Mimek32/Engineering-Thesis/3D Scanner with IR sensor Central Unit.png

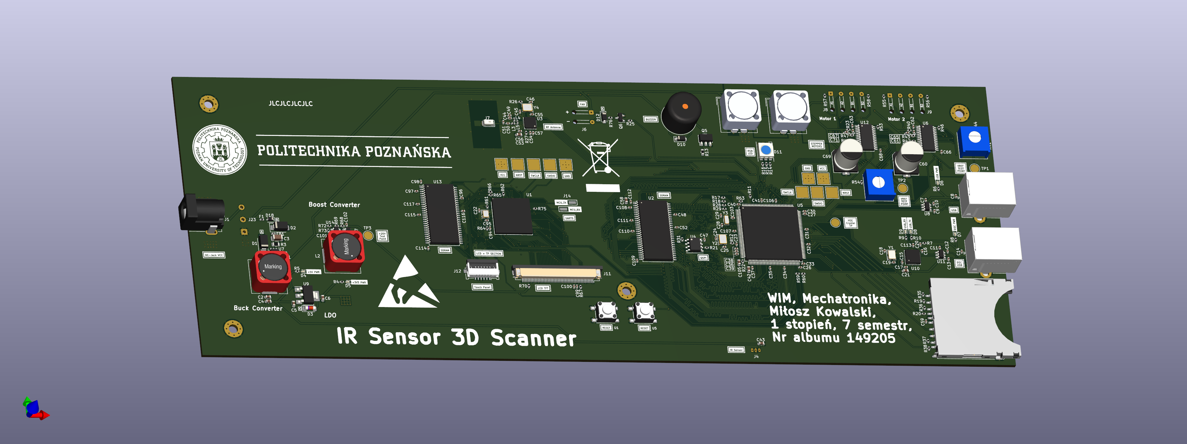
3D Scanner with IR sensor Central Unit.png
