Mimek32/Engineering-Thesis/README.md

# Engineering Thesis
## PCB
3D Scanner with IR sensor Central Unit
