Mimek32/Engineering-Thesis/3D Models/Download_STP_830069392 (rev1).stp

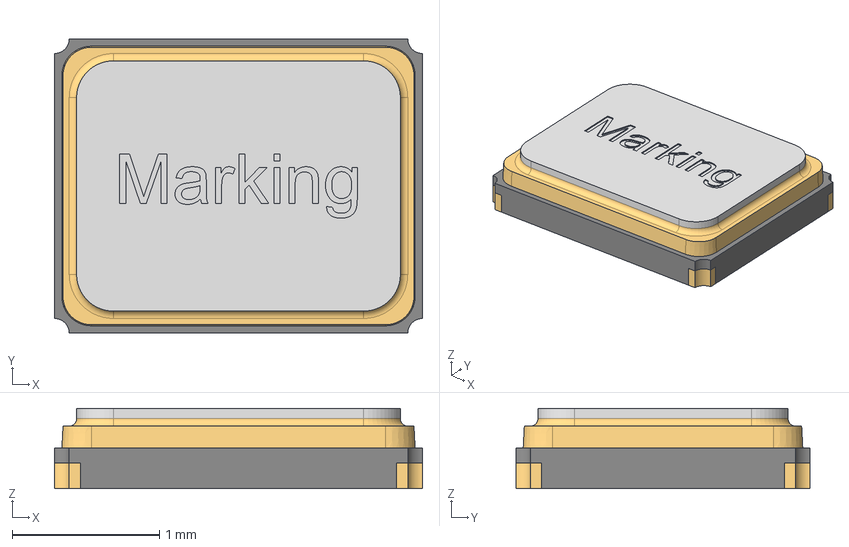
[picture p2: CAD file, 2023-10-10]
3D Models/Download_STP_830069392 (rev1).stp
2.50 x 2.00 x 0.545 mm
Pins
Cover
