Mimek32/Engineering-Thesis/3D Models/DRQ127-150-R.stp

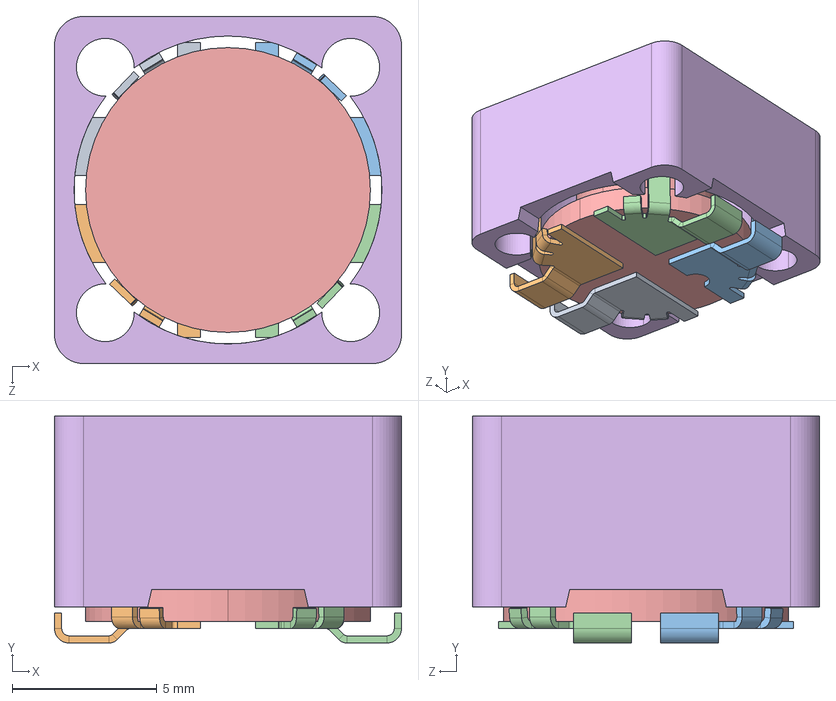
[picture p3: CAD file, 2023-10-10]
3D Models/DRQ127-150-R.stp
12.0 x 7.85 x 12.0 mm
40001700A
