Mimek32/Engineering-Thesis/3D Models/Download_STP_61400416121 (rev1).stp

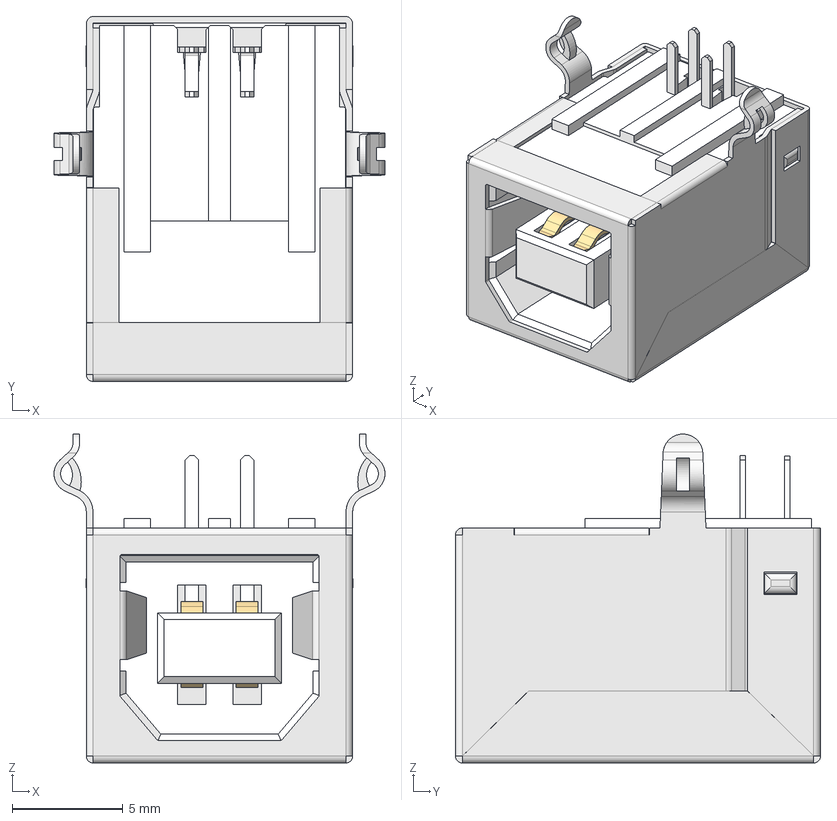
[picture p4: CAD file, 2023-10-10]
3D Models/Download_STP_61400416121 (rev1).stp
15.0 x 16.5 x 14.9 mm
61400416121_Insulator
61400416121_Shielding
61400416121_Pin_2 x 2
61400416121_Pin x 2
