Mimek32/Engineering-Thesis/3D Models/BRAK_OZNACZENIA_PRODUCENTA.stp

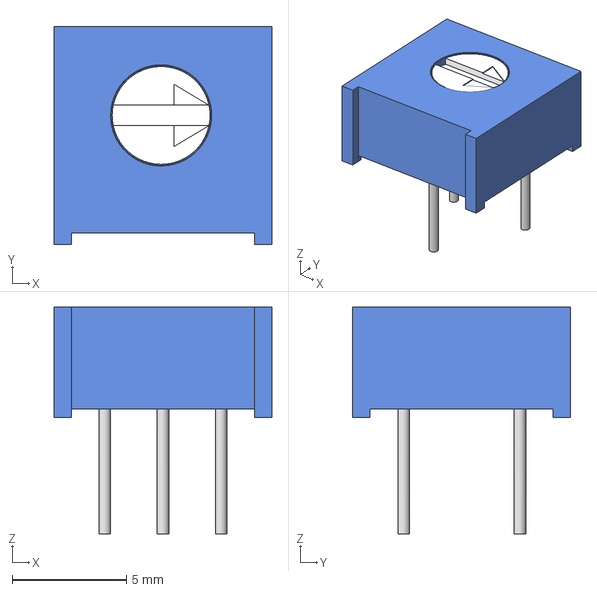
[picture p5: CAD file, 2023-10-10]
3D Models/BRAK_OZNACZENIA_PRODUCENTA.stp
9.53 x 9.53 x 9.90 mm
