Mimek32/Engineering-Thesis/3D Models/Download_STP_WL-SICW_0402 (rev1).stp

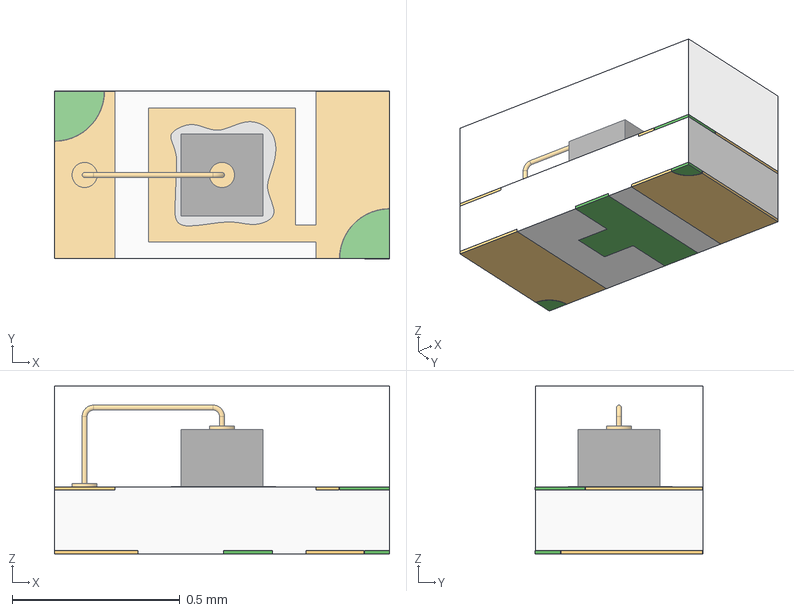
[picture p6: CAD file, 2023-10-10]
3D Models/Download_STP_WL-SICW_0402 (rev1).stp
1.00 x 0.5 x 0.5 mm
PCB
Resin
Pins
