Mimek32/Engineering-Thesis/3D Models/Download_STP_830108313809 (rev1).stp

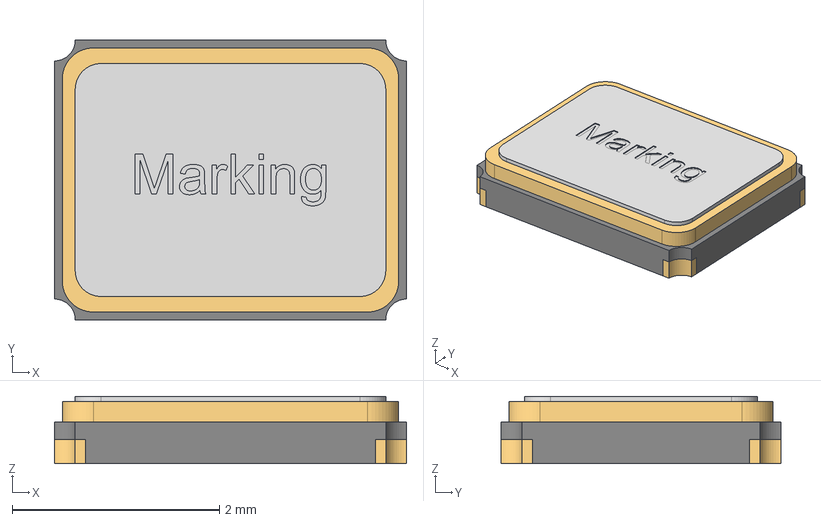
[picture p7: CAD file, 2023-10-10]
3D Models/Download_STP_830108313809 (rev1).stp
3.40 x 2.70 x 0.65 mm
Pins
Cover
