Mimek32/Engineering-Thesis/3D Models/3362P-1-102LF.stp

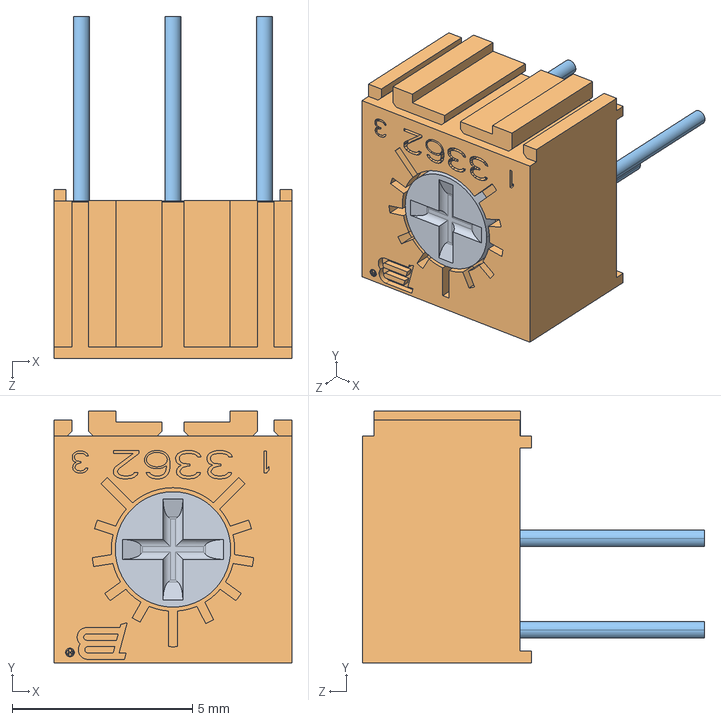
[picture p8: CAD file, 2023-10-10]
3D Models/3362P-1-102LF.stp
6.60 x 6.99 x 9.50 mm
