Mimek32/Engineering-Thesis/3D Models/Download_STP_830009678 (rev1).stp

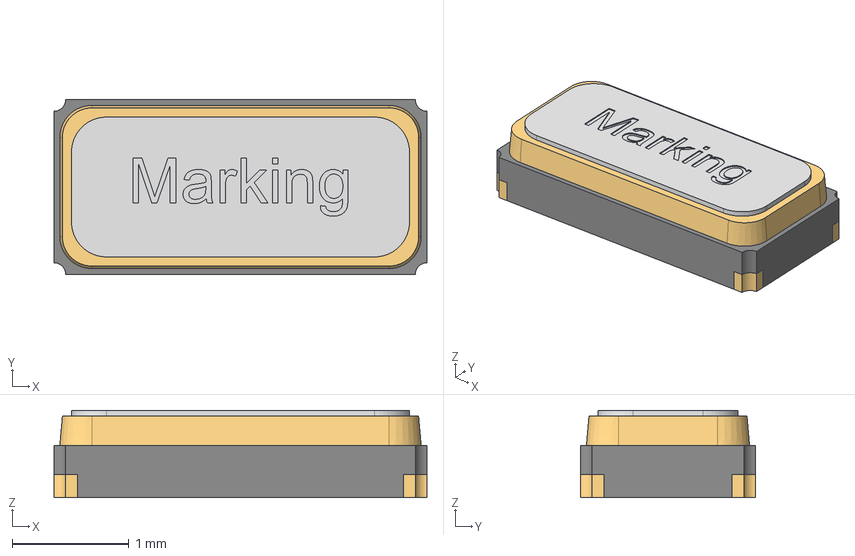
[picture p9: CAD file, 2023-10-10]
3D Models/Download_STP_830009678 (rev1).stp
3.20 x 1.50 x 0.75 mm
Pins
Cover
