Mimek32/Engineering-Thesis/3D Models/WE-PF_1280_PF (rev1).stp

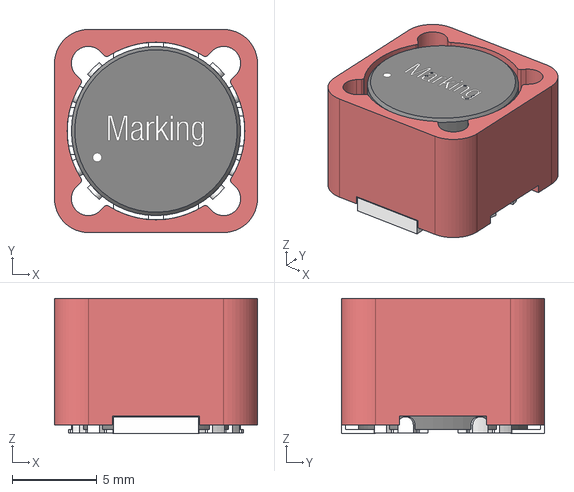
[picture p10: CAD file, 2023-10-10]
3D Models/WE-PF_1280_PF (rev1).stp
12.0 x 12.0 x 8.00 mm
