Mimek32/Engineering-Thesis/3D Models/68610614422 (rev1).stp

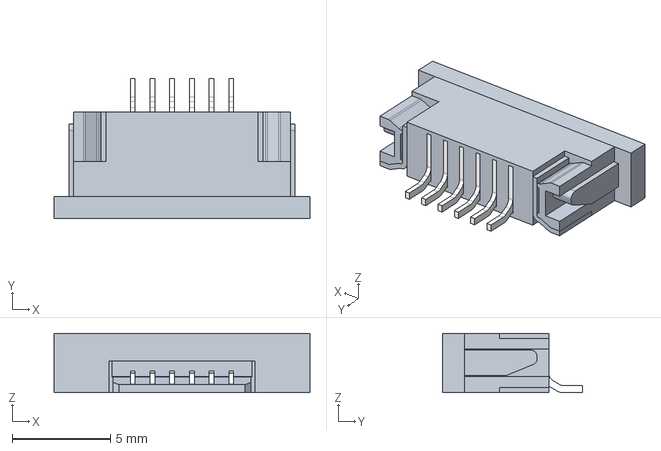
[picture p11: CAD file, 2023-10-10]
3D Models/68610614422 (rev1).stp
13.0 x 7.10 x 3.01 mm
