Mimek32/Engineering-Thesis/3D Models/430182043816 (rev1).stp

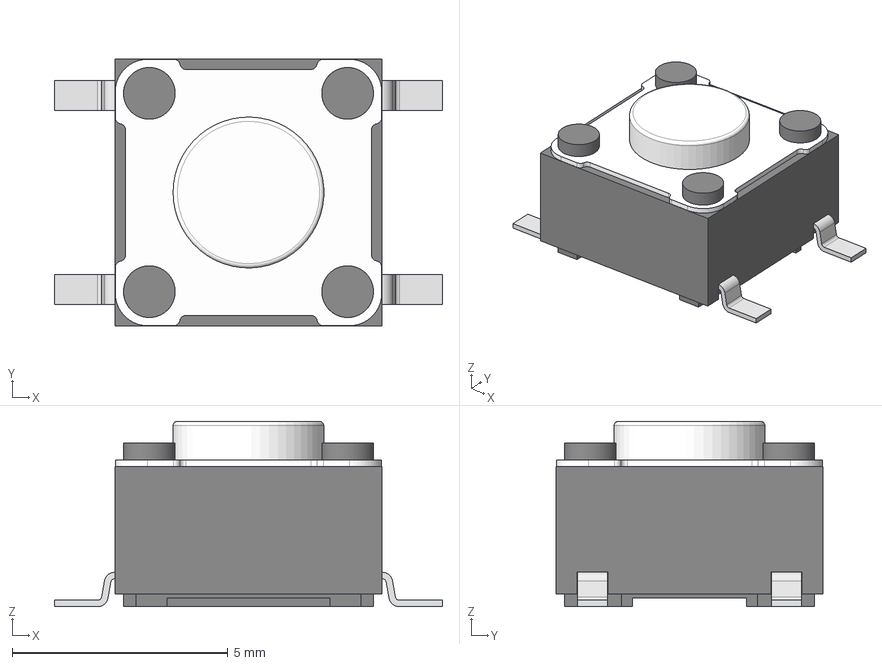
[picture p12: CAD file, 2023-10-10]
3D Models/430182043816 (rev1).stp
9.00 x 6.20 x 4.30 mm
