Mimek32/Engineering-Thesis/3D Models/693061010911 (rev1).stp

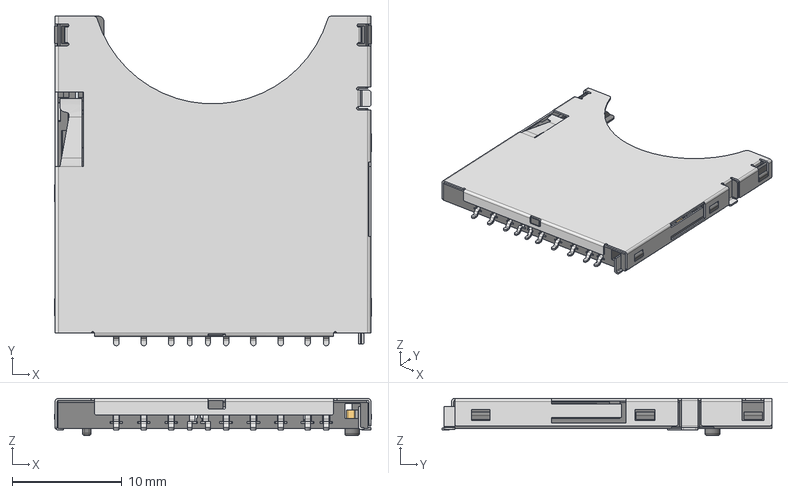
[picture p13: CAD file, 2023-10-10]
3D Models/693061010911 (rev1).stp
28.9 x 30.1 x 3.40 mm
693061010911_RESSORT
693061010911_PIN_MOY x 7
693061010911_COULISSEAU
693061010911_AGRAPHE
693061010911_PIN_SPE
693061010911_PIN_DTE
693061010911_PIN_LG
693061010911_CACHE
693061010911_PIN_GCH
