Mimek32/Engineering-Thesis/3D Models/68715014522 (rev1).stp

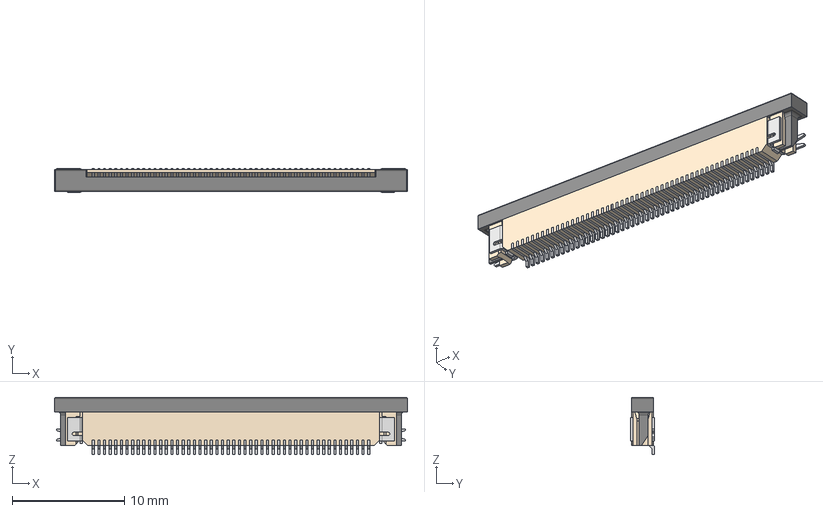
[picture p14: CAD file, 2023-10-10]
3D Models/68715014522 (rev1).stp
31.4 x 2.10 x 5.10 mm
6871xx14522_PIN x 50
6871xx14522_Patte
6871xx14522_Patte_2
68715014522_CAP
