Mimek32/Engineering-Thesis/3D Models/686106148922 (rev1).stp

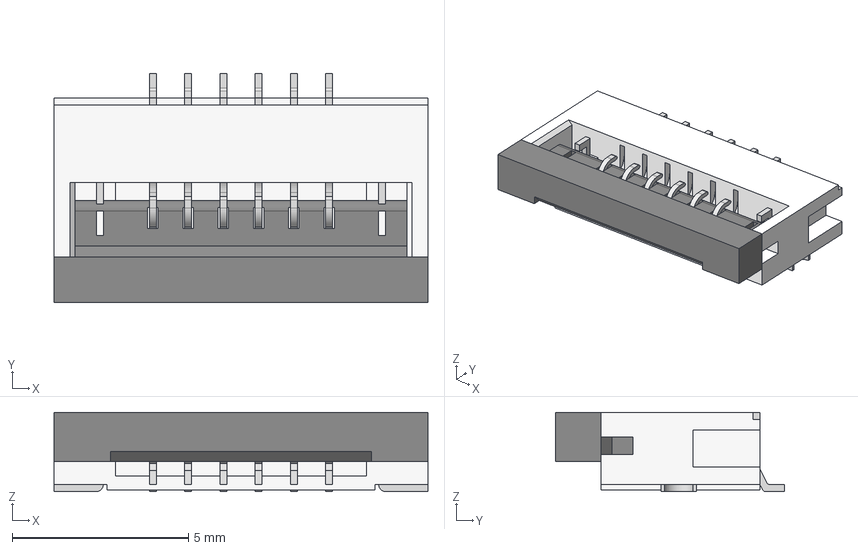
[picture p15: CAD file, 2023-10-10]
3D Models/686106148922 (rev1).stp
10.6 x 6.50 x 2.25 mm
6861xx148922_Patte
6861xx148922_Patte2
6861xx148922_Pin x 6
686106148922_Actuator
