Mimek32/Engineering-Thesis/3D Models/694108301002 (rev1).stp

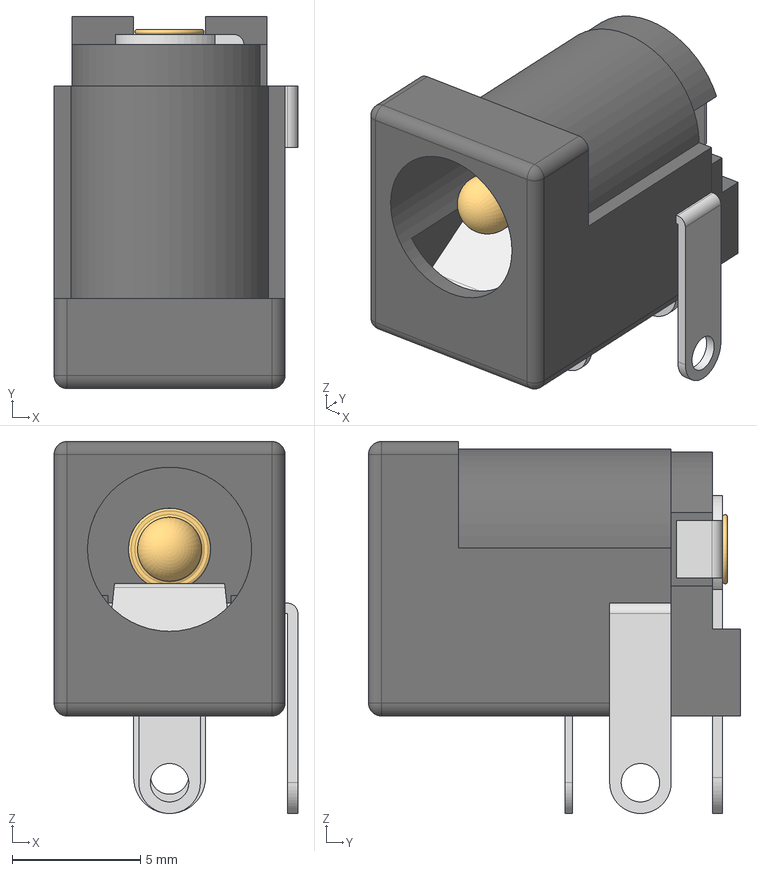
[picture p16: CAD file, 2023-10-10]
3D Models/694108301002 (rev1).stp
9.50 x 14.5 x 14.5 mm
6941xx301002
694108301002_PinContact
6941xx301002_Back
6941xx301002_PinContact2
6941xx301002_PinLame
6941xx301002_PinBis
