Mimek32/Engineering-Thesis/3D Scanner with IR sensor Central Unit.kicad_sch

## KiCad design 3D Scanner with IR sensor Central Unit.kicad_sch (2023-10-09)

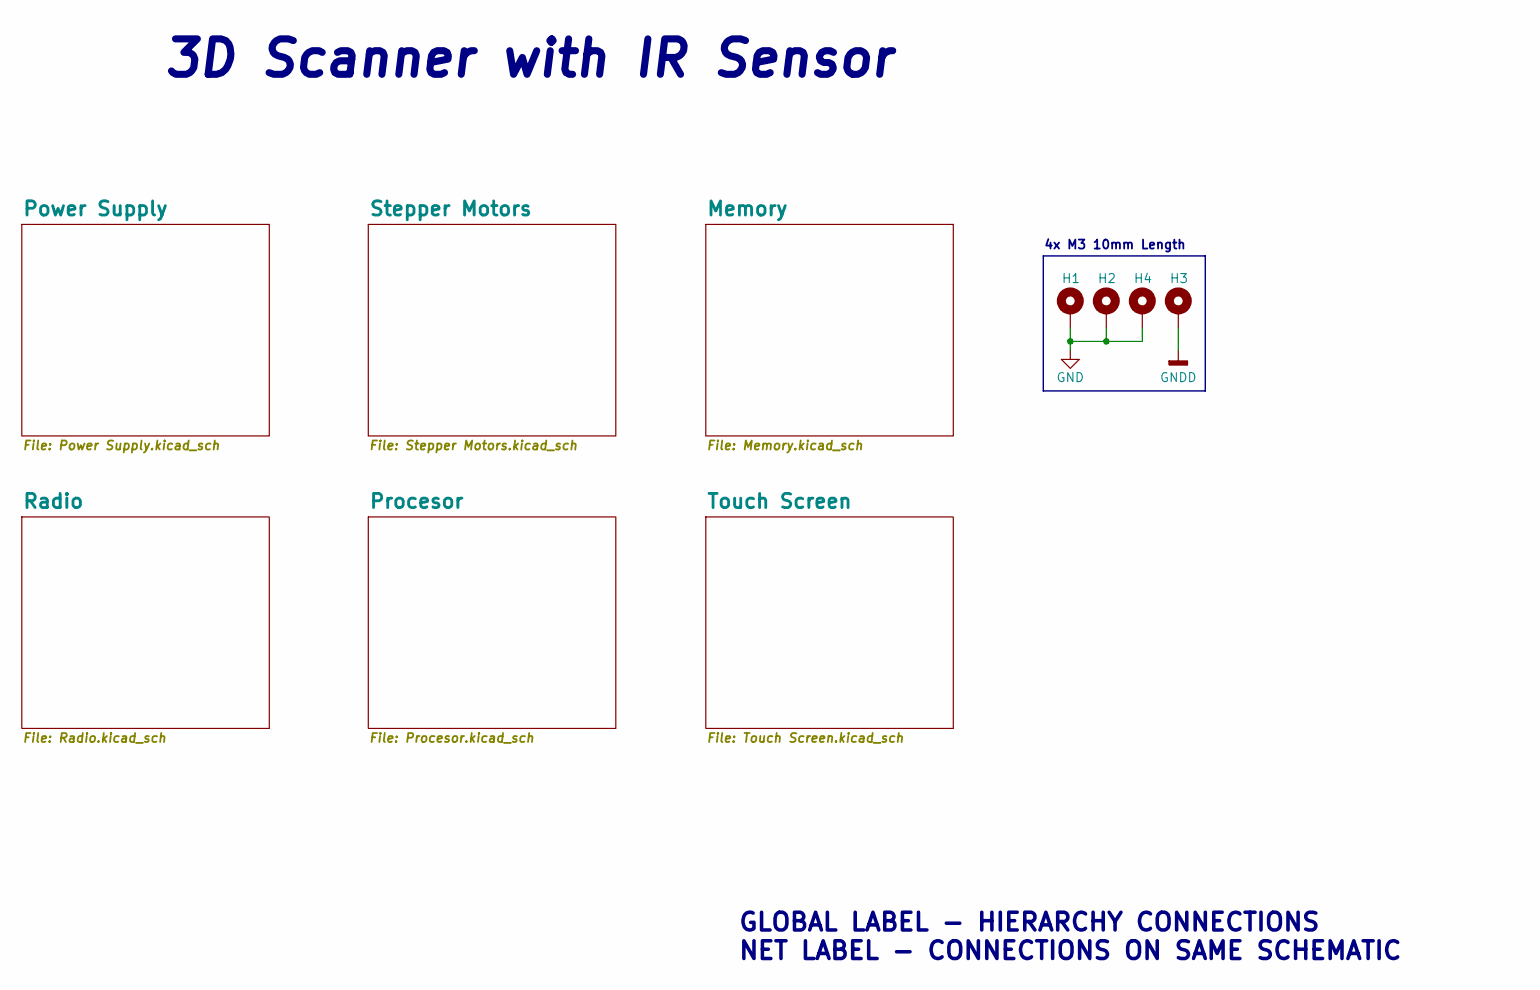
[picture p17: schematic 3D Scanner with IR sensor Central Unit.kicad_sch]

Parts:
H1, H2, H3, H4: MountingHole_Pad; MountingHole_3.2mm_M3_Pad_Via

Connections:
GND: H1.1, H2.1, H4.1
GNDD: H3.1

Notes on the sheet:
4x M3 10mm Length
GLOBAL LABEL - HIERARCHY CONNECTIONS NET LABEL - CONNECTIONS ON SAME SCHEMATIC
3D Scanner with IR Sensor
