Mimek32/Engineering-Thesis/Memory.kicad_sch

## KiCad design Memory.kicad_sch (2023-10-09)

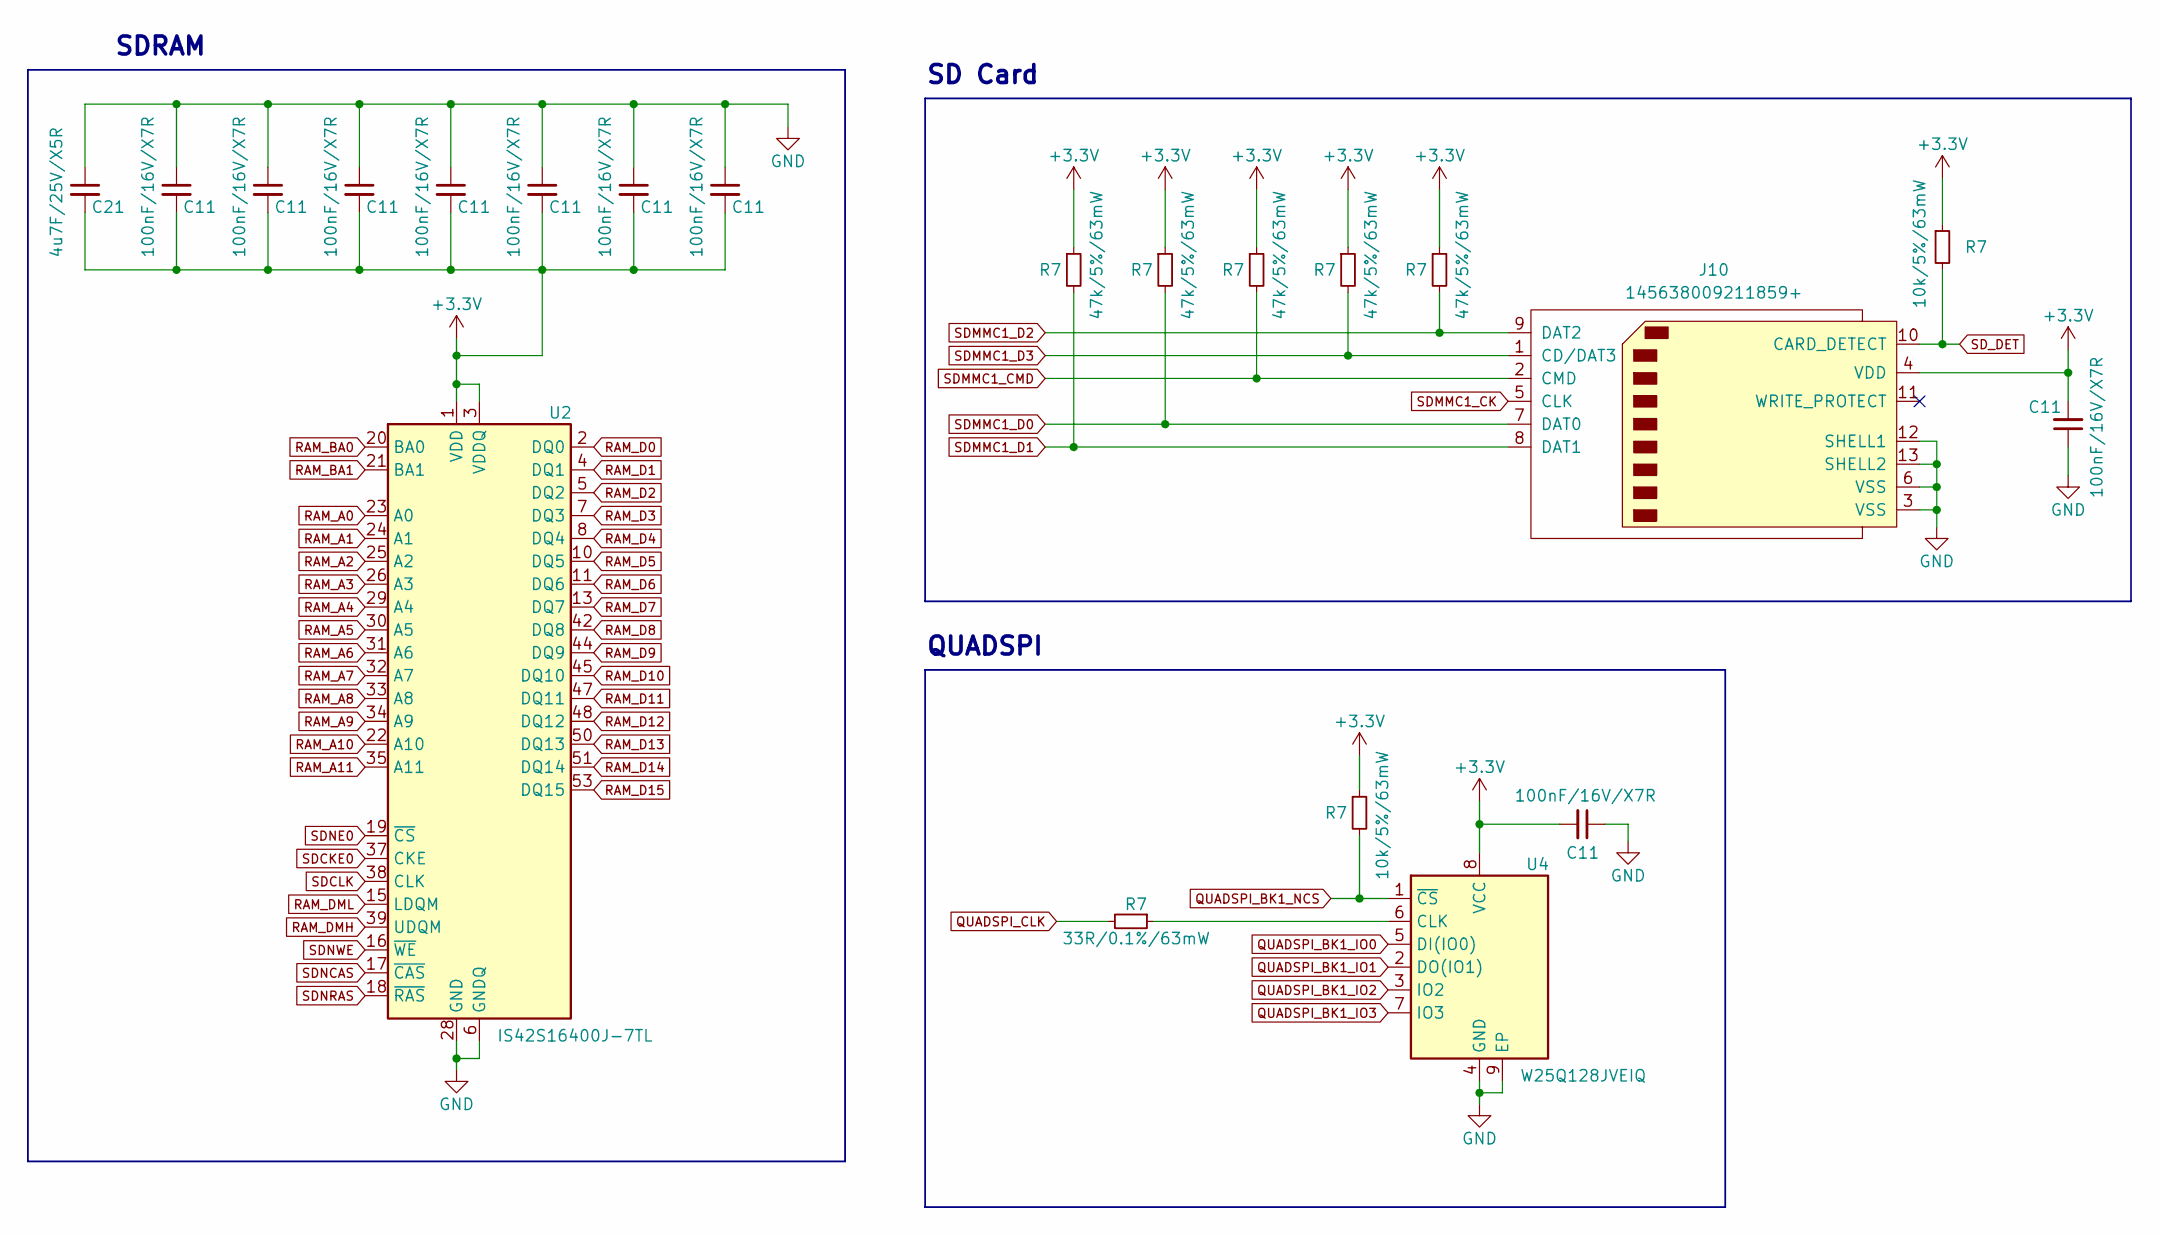
[picture p18: schematic Memory.kicad_sch]

Parts:
C11: 100nF/16V/X7R; C_0402_1005Metric
C21: 4u7F/25V/X5R; C_0603_1608Metric
J10: 145638009211859+; SD_Kyocera_145638009211859+
R7: 10k/5%/63mW; R_0402_1005Metric
U2: IS42S16400J-7TL; TSOP-II-54_22.2x10.16mm_P0.8mm
U4: W25Q128JVEIQ; WSON-8-1EP_6x5mm_P1.27mm_EP3.4x4mm

Connections:
+3.3V: C11.2, C21.2, J10.4 (VDD), R7.1, U2.1 (VDD), U2.3 (VDDQ), U2.9 (VDDQ), U2.14 (VDD), U2.27 (VDD), U2.43 (VDDQ), U2.49 (VDDQ), U4.8 (VCC)
GND: C11.1, C21.1, J10.3 (VSS), J10.6 (VSS), J10.12 (SHELL1), J10.13 (SHELL2), U2.6 (GNDQ), U2.12 (GNDQ), U2.28 (GND), U2.41 (GND), U2.46 (GNDQ), U2.52 (GNDQ), U2.54 (GND), U4.4 (GND), U4.9 (EP)
unnamed: R7.1, U4.6 (CLK)
QUADSPI_BK1_IO0: U4.5 (DI(IO0))
QUADSPI_BK1_IO1: U4.2 (DO(IO1))
QUADSPI_BK1_IO2: U4.3 (IO2)
QUADSPI_BK1_IO3: U4.7 (IO3)
QUADSPI_BK1_NCS: R7.2, U4.1 (~CS)
QUADSPI_CLK: R7.2
RAM_A0: U2.23 (A0)
RAM_A1: U2.24 (A1)
RAM_A2: U2.25 (A2)
RAM_A3: U2.26 (A3)
RAM_A4: U2.29 (A4)
RAM_A5: U2.30 (A5)
RAM_A6: U2.31 (A6)
RAM_A7: U2.32 (A7)
RAM_A8: U2.33 (A8)
RAM_A9: U2.34 (A9)
RAM_A10: U2.22 (A10)
RAM_A11: U2.35 (A11)
RAM_BA0: U2.20 (BA0)
RAM_BA1: U2.21 (BA1)
RAM_D0: U2.2 (DQ0)
RAM_D1: U2.4 (DQ1)
RAM_D2: U2.5 (DQ2)
RAM_D3: U2.7 (DQ3)
RAM_D4: U2.8 (DQ4)
RAM_D5: U2.10 (DQ5)
RAM_D6: U2.11 (DQ6)
RAM_D7: U2.13 (DQ7)
RAM_D8: U2.42 (DQ8)
RAM_D9: U2.44 (DQ9)
RAM_D10: U2.45 (DQ10)
RAM_D11: U2.47 (DQ11)
RAM_D12: U2.48 (DQ12)
RAM_D13: U2.50 (DQ13)
RAM_D14: U2.51 (DQ14)
RAM_D15: U2.53 (DQ15)
RAM_DMH: U2.39 (UDQM)
RAM_DML: U2.15 (LDQM)
SDCKE0: U2.37 (CKE)
SDCLK: U2.38 (CLK)
SDMMC1_CK: J10.5 (CLK)
SDMMC1_CMD: J10.2 (CMD), R7.2
SDMMC1_D0: J10.7 (DAT0), R7.2
SDMMC1_D1: J10.8 (DAT1), R7.2
SDMMC1_D2: J10.9 (DAT2), R7.2
SDMMC1_D3: J10.1 (CD/DAT3), R7.2
SDNCAS: U2.17 (~CAS)
SDNE0: U2.19 (~CS)
SDNRAS: U2.18 (~RAS)
SDNWE: U2.16 (~WE)
SD_DET: J10.10 (CARD_DETECT), R7.2

Notes on the sheet:
QUADSPI
SDRAM
SD Card
