Mimek32/Engineering-Thesis/Power Supply.kicad_sch

## KiCad design Power Supply.kicad_sch (2023-10-09)

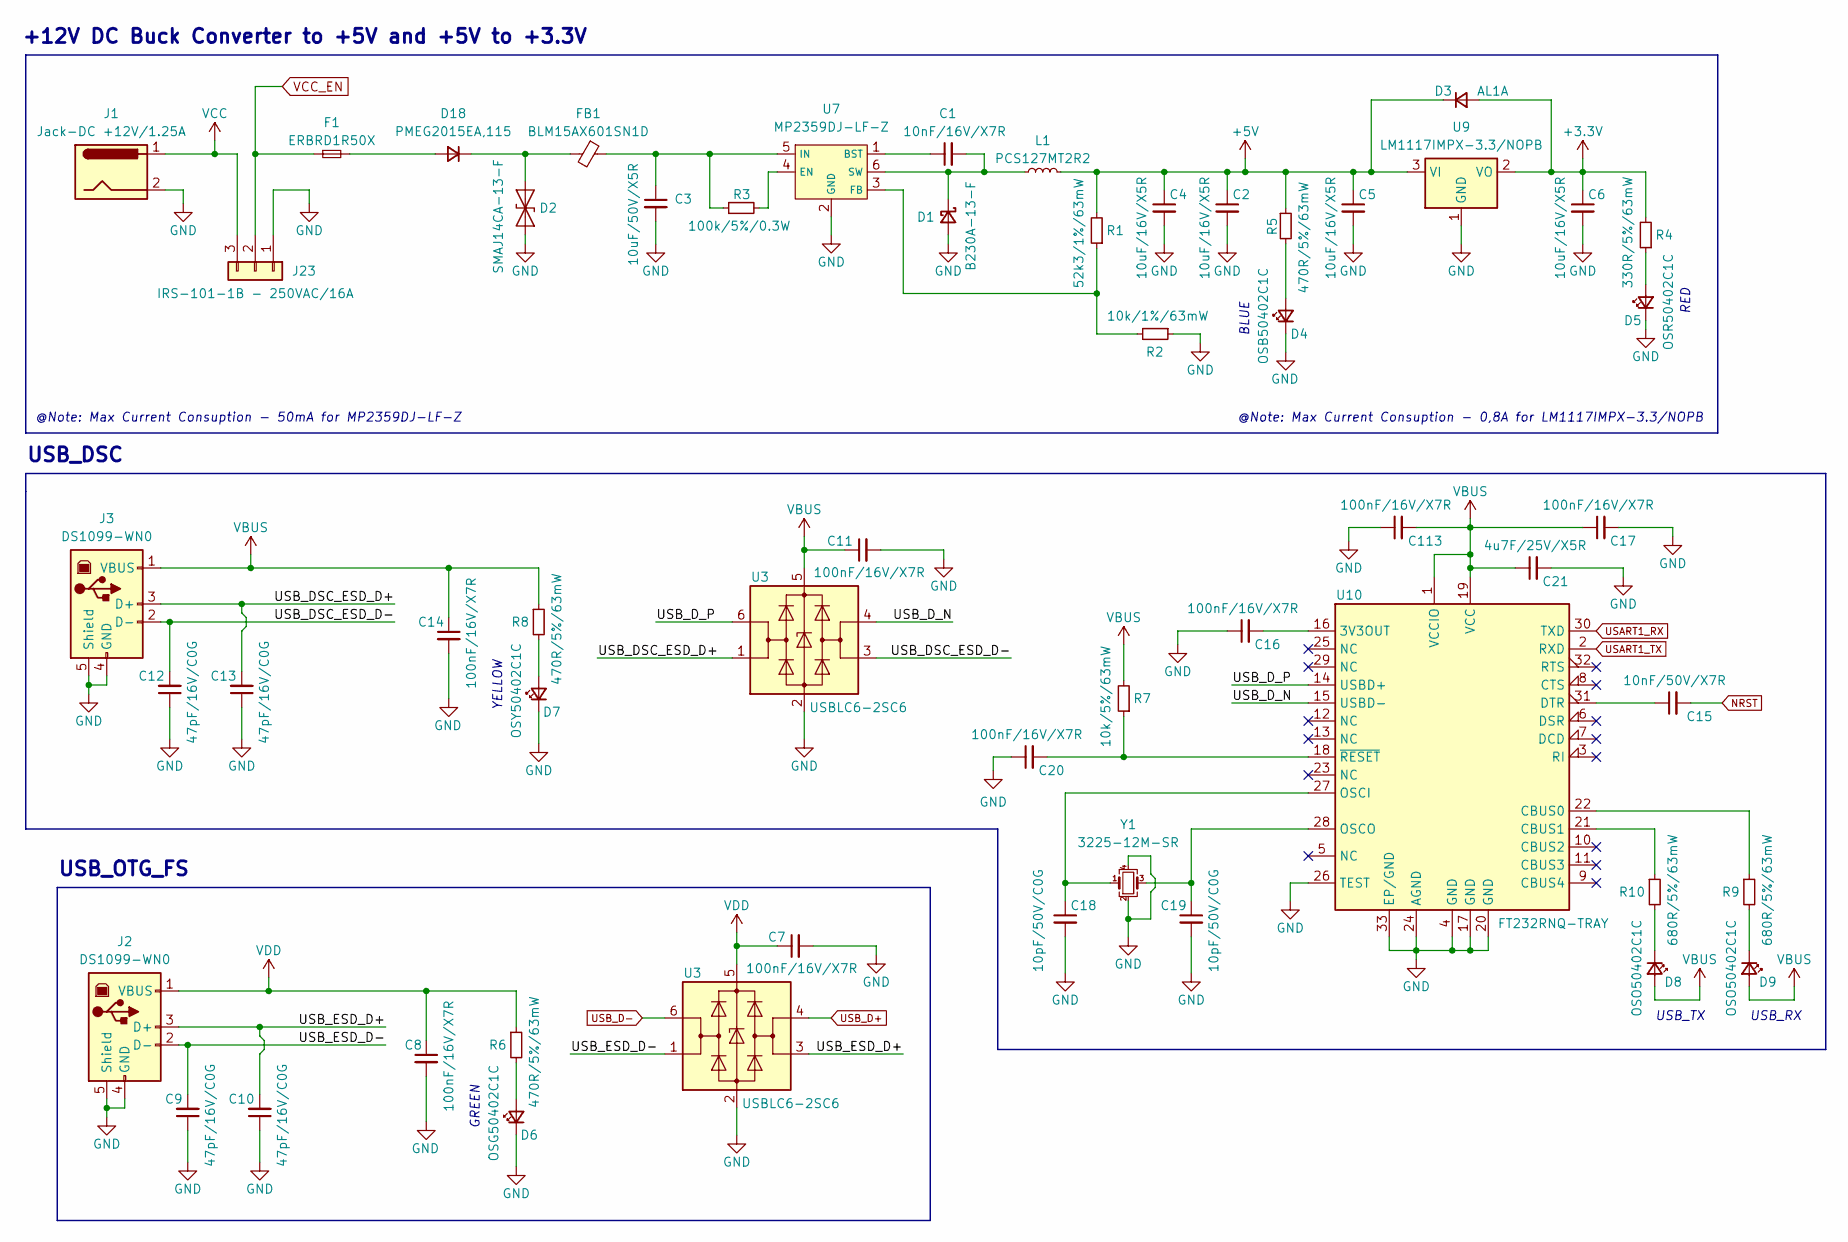
[picture p19: schematic Power Supply.kicad_sch]

Parts:
C1: 10nF/16V/X7R; C_0402_1005Metric
C2, C4, C5, C6: 10uF/16V/X5R; C_0603_1608Metric
C3: 10uF/50V/X5R; C_1206_3216Metric
C7, C8, C11, C14, C16, C17, C20, C113: 100nF/16V/X7R; C_0402_1005Metric
C9, C10, C12, C13: 47pF/16V/C0G; C_0402_1005Metric
C15: 10nF/50V/X7R; C_0402_1005Metric
C18, C19: 10pF/50V/C0G; C_0402_1005Metric
C21: 4u7F/25V/X5R; C_0603_1608Metric
D1: B230A-13-F; D_SMA
D2: SMAJ14CA-13-F; D_SMA
D3: AL1A; D_MiniMELF
D4: OSB50402C1C; D_0402_1005Metric
D5: OSR50402C1C; D_0402_1005Metric
D6: OSG50402C1C; D_0402_1005Metric
D7: OSY50402C1C; D_0402_1005Metric
D8, D9: OSO50402C1C; D_0402_1005Metric
D18: PMEG2015EA,115; D_SOD-323
F1: ERBRD1R50X; Fuse_0402_1005Metric
FB1: BLM15AX601SN1D; L_0402_1005Metric
J1: Jack-DC +12V/1.25A; BarrelJack_GCT_DCJ200-10-A_Horizontal
J2, J3: DS1099-WN0; USB_B_Lumberg_2411_02_Horizontal
J23: IRS-101-1B - 250VAC/16A; SolderWire-0.5sqmm_1x03_P4.6mm_D0.9mm_OD2.1mm
L1: PCS127MT2R2; L_12x12mm_H8mm
R1: 52k3/1%/63mW; R_0402_1005Metric
R2: 10k/1%/63mW; R_0402_1005Metric
R3: 100k/5%/0.3W; R_0805_2012Metric
R4: 330R/5%/63mW; R_0402_1005Metric
R5, R6, R8: 470R/5%/63mW; R_0402_1005Metric
R7: 10k/5%/63mW; R_0402_1005Metric
R9, R10: 680R/5%/63mW; R_0402_1005Metric
U3: USBLC6-2SC6; SOT-23-6
U7: MP2359DJ-LF-Z; SOT-23-6
U9: LM1117IMPX-3.3/NOPB; SOT-223-3_TabPin2
U10: FT232RNQ-TRAY; QFN-32-1EP_5x5mm_P0.5mm_EP3.1x3.1mm
Y1: 3225-12M-SR; Crystal_SMD_3225-4Pin_3.2x2.5mm

Connections:
+3.3V: C6.1, D3.2 (A), R4.2, U9.2 (VO)
+5V: C2.1, C4.1, C5.1, D3.1 (K), L1.2, R1.2, R5.1, U9.3 (VI)
GND: C2.2, C3.2, C4.2, C5.2, C6.2, C7.2, C8.2, C9.1, C10.1, C11.2, C12.1, C13.1, C14.2, C16.1, C17.2, C18.2, C19.2, C20.1, C21.2, C113.1, D1.2 (A), D2.2 (A2), D4.1 (K), D5.1 (K), D6.1 (K), D7.1 (K), J1.2, J2.4 (GND), J2.5 (Shield), J3.4 (GND), J3.5 (Shield), J23.1, R2.1, U3.2 (GND), U7.2 (GND), U9.1 (GND), U10.4 (GND), U10.17 (GND), U10.20 (GND), U10.24 (AGND), U10.26 (TEST), U10.33 (EP/GND), Y1.2, Y1.4
NRST: C15.2
unnamed: C1.1, U7.1 (BST)
unnamed: C1.2, D1.1 (K), L1.1, U7.6 (SW)
unnamed: C3.1, FB1.1, R3.1, U7.5 (IN)
unnamed: C15.1, U10.31 (DTR)
unnamed: C16.2, U10.16 (3V3OUT)
unnamed: C18.1, U10.27 (OSCI), Y1.1
unnamed: C19.1, U10.28 (OSCO), Y1.3
unnamed: C20.2, R7.1, U10.18 (~RESET)
unnamed: D4.2 (A), R5.2
unnamed: D5.2 (A), R4.1
unnamed: D6.2 (A), R6.2
unnamed: D7.2 (A), R8.2
unnamed: D8.1 (K), R10.2
unnamed: D9.1 (K), R9.2
unnamed: D2.1 (A1), D18.1 (K), FB1.2
unnamed: D18.2 (A), F1.2
unnamed: R1.1, R2.2, U7.3 (FB)
unnamed: R3.2, U7.4 (EN)
unnamed: R9.1, U10.22 (CBUS0)
unnamed: R10.1, U10.21 (CBUS1)
USART1_RX: U10.30 (TXD)
USART1_TX: U10.2 (RXD)
USB_D+: U3.4 (I/O2)
USB_D-: U3.6 (I/O1)
USB_DSC_ESD_D+: C13.2, J3.3 (D+), U3.1 (I/O1)
USB_DSC_ESD_D-: C12.2, J3.2 (D-), U3.3 (I/O2)
USB_D_N: U3.4 (I/O2), U10.15 (USBD-)
USB_D_P: U3.6 (I/O1), U10.14 (USBD+)
USB_ESD_D+: C10.2, J2.3 (D+), U3.3 (I/O2)
USB_ESD_D-: C9.2, J2.2 (D-), U3.1 (I/O1)
VBUS: C11.1, C14.1, C17.1, C21.1, C113.2, D8.2 (A), D9.2 (A), J3.1 (VBUS), R7.2, R8.1, U3.5 (VBUS), U10.1 (VCCIO), U10.19 (VCC)
VCC: J1.1, J23.3
VCC_EN: F1.1, J23.2
VDD: C7.1, C8.1, J2.1 (VBUS), R6.1, U3.5 (VBUS)

Notes on the sheet:
YELLOW
USB_TX
USB_RX
RED
USB_OTG_FS
@Note: Max Current Consuption - 50mA for MP2359DJ-LF-Z
+12V DC Buck Converter to +5V and +5V to +3.3V
BLUE
@Note: Max Current Consuption - 0,8A for LM1117IMPX-3.3/NOPB
GREEN
USB_DSC
