Mimek32/Engineering-Thesis/Procesor.kicad_sch

## KiCad design Procesor.kicad_sch (2023-10-09)

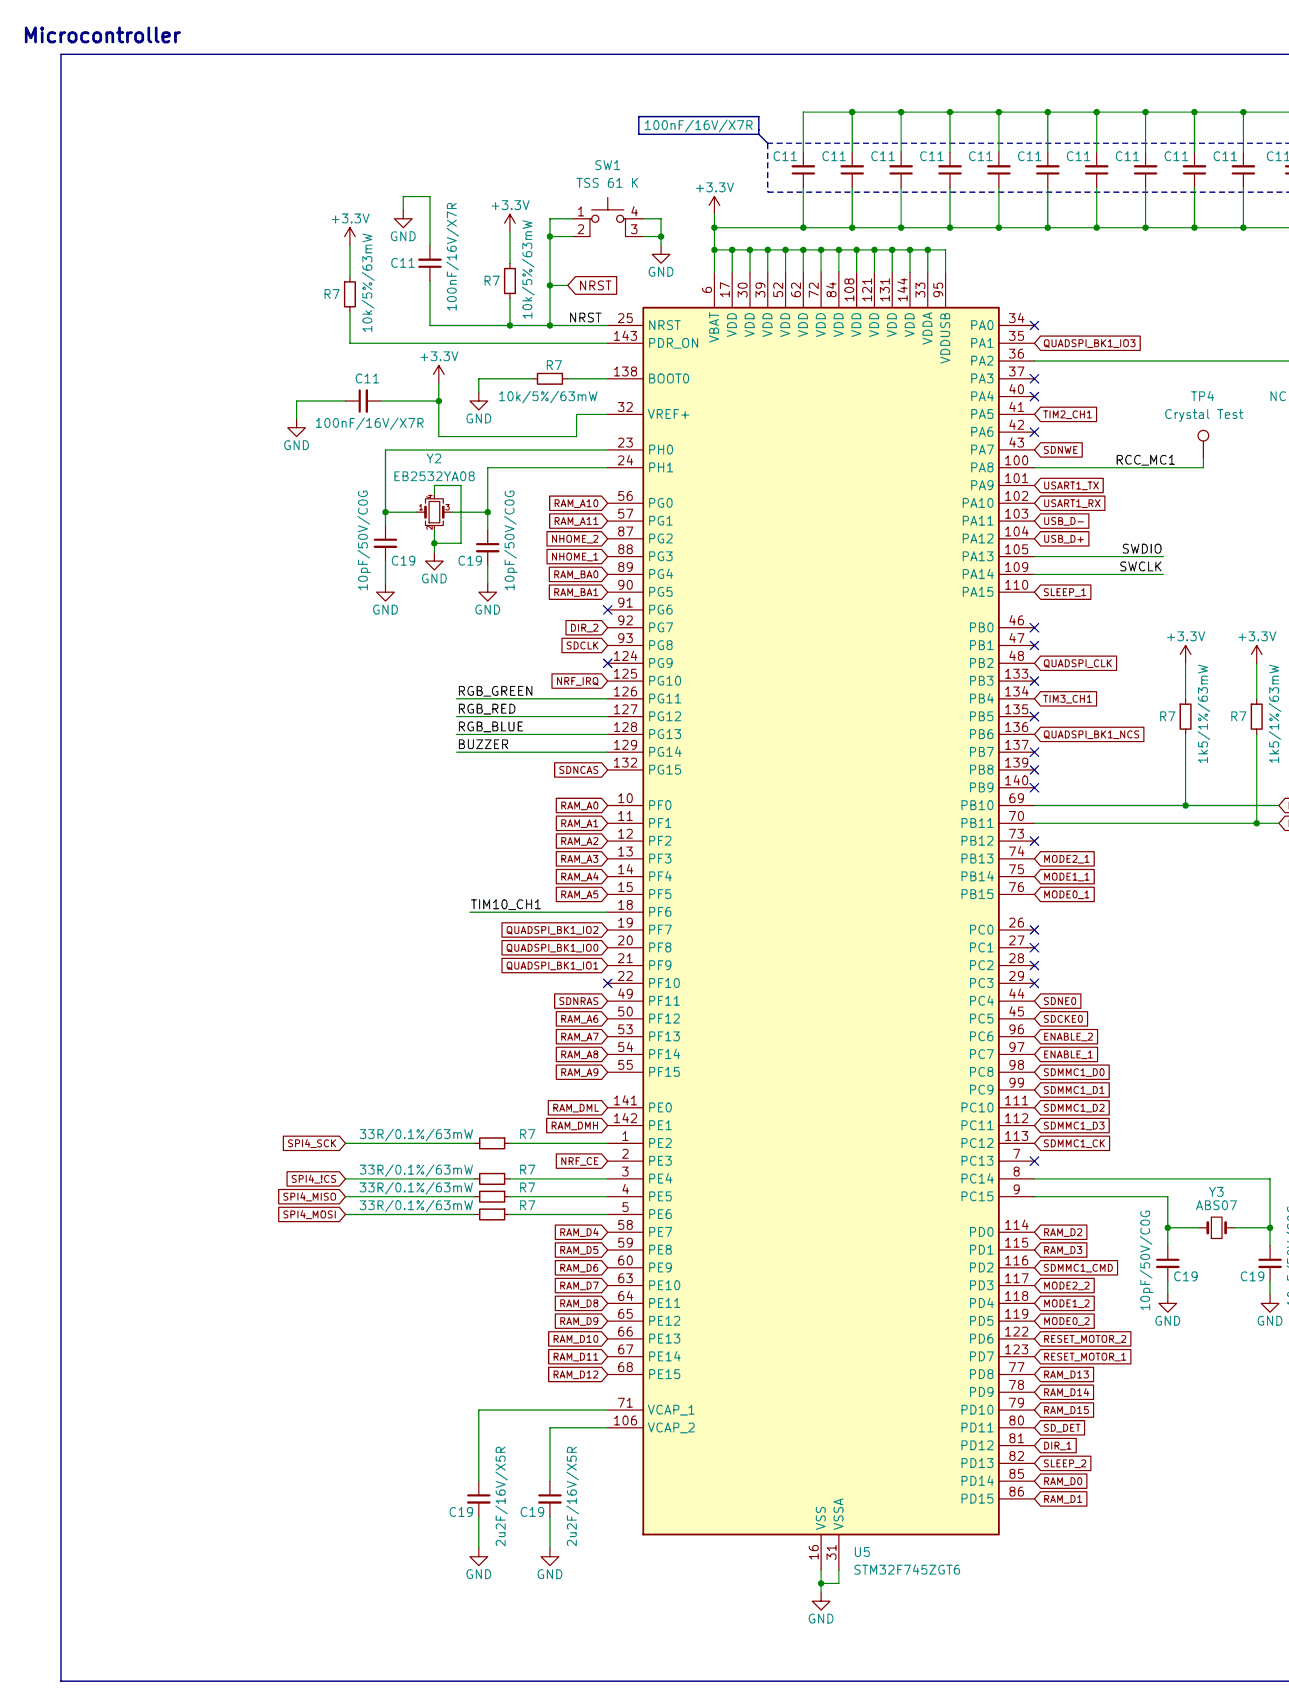
[picture p20: schematic Procesor.kicad_sch, part in row 1, column 1]

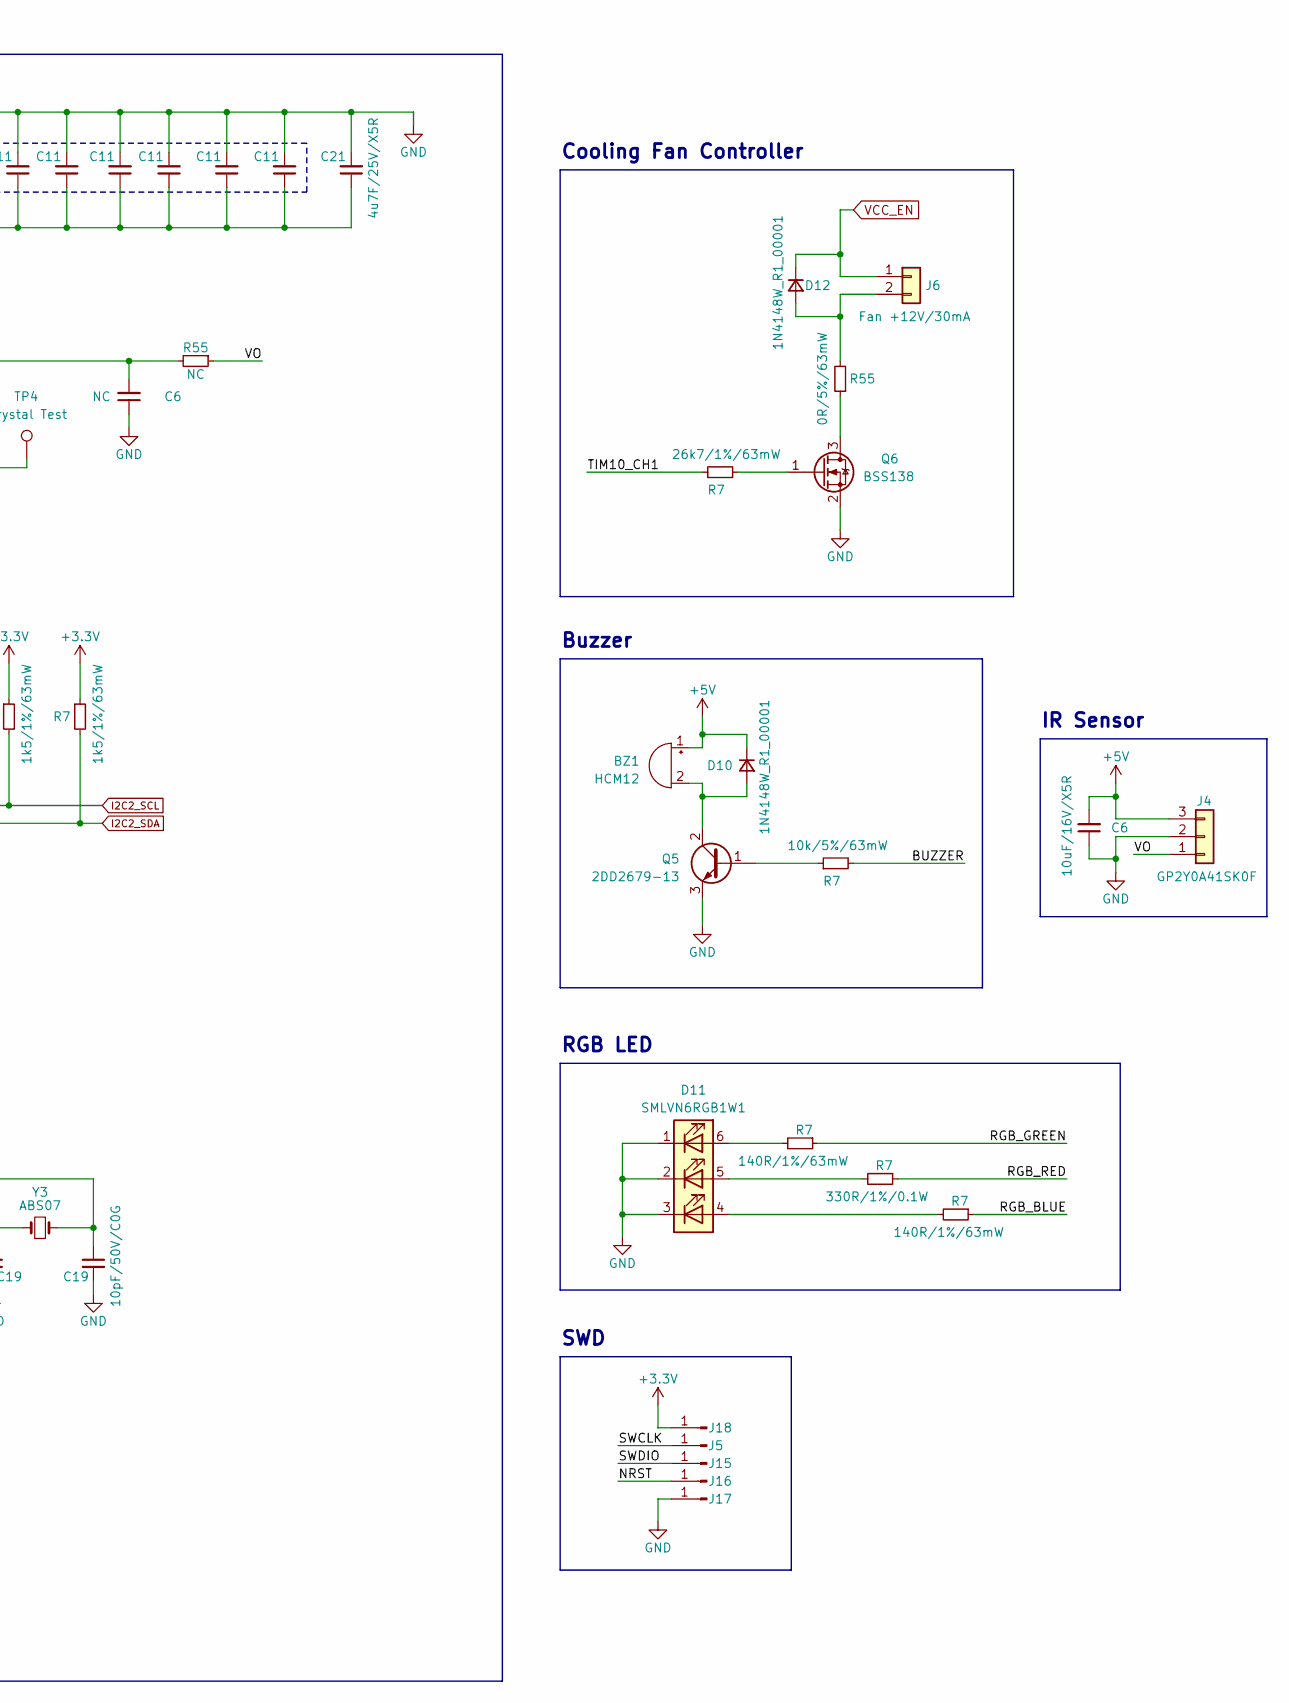
[picture p21: schematic Procesor.kicad_sch, part in row 1, column 2]

Parts:
BZ1: HCM12; Buzzer_12x9.5RM7.6
C6: NC; C_0603_1608Metric
C11: 100nF/16V/X7R; C_0402_1005Metric
C19: 10pF/50V/C0G; C_0402_1005Metric
C21: 4u7F/25V/X5R; C_0603_1608Metric
D10, D12: 1N4148W_R1_00001; D_SOD-123
D11: SMLVN6RGB1W1; LED_ROHM_SMLVN6
J4: GP2Y0A41SK0F; Molex_PicoBlade_53048-0310_1x03_P1.25mm_Horizontal
J5, J15, J16, J17, J18: Conn_01x01_Pin; TestPoint_Pad_4.0x4.0mm
J6: Fan +12V/30mA; SolderWire-0.1sqmm_1x02_P3.6mm_D0.4mm_OD1mm_Relief
Q5: 2DD2679-13; SOT-89-3
Q6: BSS138; SOT-23
R7: 10k/5%/63mW; R_0402_1005Metric
R55: NC; R_0402_1005Metric
SW1: TSS 61 K; SW_Push_1P1T_NO_6x6mm_H9.5mm
TP4: Crystal Test; TestPoint_Pad_D3.0mm
U5: STM32F745ZGT6; LQFP-144_20x20mm_P0.5mm
Y2: EB2532YA08; Crystal_SMD_Abracon_ABM8AIG-4Pin_3.2x2.5mm
Y3: ABS07; Crystal_SMD_3215-2Pin_3.2x1.5mm

Connections:
+3.3V: C11.1, C11.2, C21.1, J18.1, R7.1, U5.6 (VBAT), U5.17 (VDD), U5.30 (VDD), U5.32 (VREF+), U5.33 (VDDA), U5.39 (VDD), U5.52 (VDD), U5.62 (VDD), U5.72 (VDD), U5.84 (VDD), U5.95 (VDDUSB), U5.108 (VDD), U5.121 (VDD), U5.131 (VDD), U5.144 (VDD)
+5V: BZ1.1 (-), C6.2, D10.1 (K), J4.3
BUZZER: R7.2, U5.129 (PG14)
DIR_1: U5.81 (PD12)
DIR_2: U5.92 (PG7)
ENABLE_1: U5.97 (PC7)
ENABLE_2: U5.96 (PC6)
GND: C6.1, C11.1, C11.2, C19.2, C21.2, D11.1 (RK), D11.2 (GK), D11.3 (BK), J4.2, J17.1, Q5.3 (E), Q6.2 (S), R7.2, SW1.3 (K), SW1.4 (A), U5.16 (VSS), U5.31 (VSSA), U5.38 (VSS), U5.51 (VSS), U5.61 (VSS), U5.83 (VSS), U5.94 (VSS), U5.107 (VSS), U5.120 (VSS), U5.130 (VSS), Y2.2, Y2.4
I2C2_SCL: R7.2, U5.69 (PB10)
I2C2_SDA: R7.2, U5.70 (PB11)
MODE0_1: U5.76 (PB15)
MODE0_2: U5.119 (PD5)
MODE1_1: U5.75 (PB14)
MODE1_2: U5.118 (PD4)
MODE2_1: U5.74 (PB13)
MODE2_2: U5.117 (PD3)
NHOME_1: U5.88 (PG3)
NHOME_2: U5.87 (PG2)
NRF_CE: U5.2 (PE3)
NRF_IRQ: U5.125 (PG10)
NRST: C11.1, J16.1, R7.2, SW1.1, SW1.2, U5.25 (NRST)
unnamed: BZ1.2 (+), D10.2 (A), Q5.2 (C)
unnamed: C6.2, R55.2, U5.36 (PA2)
unnamed: C19.1, U5.8 (PC14), U5.9 (PC15), U5.23 (PH0), U5.24 (PH1), U5.71 (VCAP_1), U5.106 (VCAP_2), Y2.1, Y2.3, Y3.1, Y3.2
unnamed: D11.4 (BA), R7.2
unnamed: D11.5 (GA), R7.2
unnamed: D11.6 (RA), R7.2
unnamed: D12.2 (A), J6.2, R55.2
unnamed: Q5.1 (B), R7.1
unnamed: Q6.1 (G), R7.2
unnamed: Q6.3 (D), R55.1
unnamed: R7.1, U5.1 (PE2), U5.3 (PE4), U5.4 (PE5), U5.5 (PE6), U5.138 (BOOT0)
unnamed: R7.2, U5.143 (PDR_ON)
QUADSPI_BK1_IO0: U5.20 (PF8)
QUADSPI_BK1_IO1: U5.21 (PF9)
QUADSPI_BK1_IO2: U5.19 (PF7)
QUADSPI_BK1_IO3: U5.35 (PA1)
QUADSPI_BK1_NCS: U5.136 (PB6)
QUADSPI_CLK: U5.48 (PB2)
RAM_A0: U5.10 (PF0)
RAM_A1: U5.11 (PF1)
RAM_A2: U5.12 (PF2)
RAM_A3: U5.13 (PF3)
RAM_A4: U5.14 (PF4)
RAM_A5: U5.15 (PF5)
RAM_A6: U5.50 (PF12)
RAM_A7: U5.53 (PF13)
RAM_A8: U5.54 (PF14)
RAM_A9: U5.55 (PF15)
RAM_A10: U5.56 (PG0)
RAM_A11: U5.57 (PG1)
RAM_BA0: U5.89 (PG4)
RAM_BA1: U5.90 (PG5)
RAM_D0: U5.85 (PD14)
RAM_D1: U5.86 (PD15)
RAM_D2: U5.114 (PD0)
RAM_D3: U5.115 (PD1)
RAM_D4: U5.58 (PE7)
RAM_D5: U5.59 (PE8)
RAM_D6: U5.60 (PE9)
RAM_D7: U5.63 (PE10)
RAM_D8: U5.64 (PE11)
RAM_D9: U5.65 (PE12)
RAM_D10: U5.66 (PE13)
RAM_D11: U5.67 (PE14)
RAM_D12: U5.68 (PE15)
RAM_D13: U5.77 (PD8)
RAM_D14: U5.78 (PD9)
RAM_D15: U5.79 (PD10)
RAM_DMH: U5.142 (PE1)
RAM_DML: U5.141 (PE0)
RCC_MC1: TP4.1, U5.100 (PA8)
RESET_MOTOR_1: U5.123 (PD7)
RESET_MOTOR_2: U5.122 (PD6)
RGB_BLUE: R7.1, U5.128 (PG13)
RGB_GREEN: R7.1, U5.126 (PG11)
RGB_RED: R7.1, U5.127 (PG12)
SDCKE0: U5.45 (PC5)
SDCLK: U5.93 (PG8)
SDMMC1_CK: U5.113 (PC12)
SDMMC1_CMD: U5.116 (PD2)
SDMMC1_D0: U5.98 (PC8)
SDMMC1_D1: U5.99 (PC9)
SDMMC1_D2: U5.111 (PC10)
SDMMC1_D3: U5.112 (PC11)
SDNCAS: U5.132 (PG15)
SDNE0: U5.44 (PC4)
SDNRAS: U5.49 (PF11)
SDNWE: U5.43 (PA7)
SD_DET: U5.80 (PD11)
SLEEP_1: U5.110 (PA15)
SLEEP_2: U5.82 (PD13)
SPI4_!CS: R7.2
SPI4_MISO: R7.2
SPI4_MOSI: R7.2
SPI4_SCK: R7.2
SWCLK: J5.1, U5.109 (PA14)
SWDIO: J15.1, U5.105 (PA13)
TIM2_CH1: U5.41 (PA5)
TIM3_CH1: U5.134 (PB4)
TIM10_CH1: R7.1, U5.18 (PF6)
USART1_RX: U5.102 (PA10)
USART1_TX: U5.101 (PA9)
USB_D+: U5.104 (PA12)
USB_D-: U5.103 (PA11)
VCC_EN: D12.1 (K), J6.1
VO: J4.1, R55.1

Notes on the sheet:
Buzzer
IR Sensor
RGB LED
Microcontroller
Cooling Fan Controller
SWD
