Mimek32/Engineering-Thesis/Radio.kicad_sch

## KiCad design Radio.kicad_sch (2023-10-09)

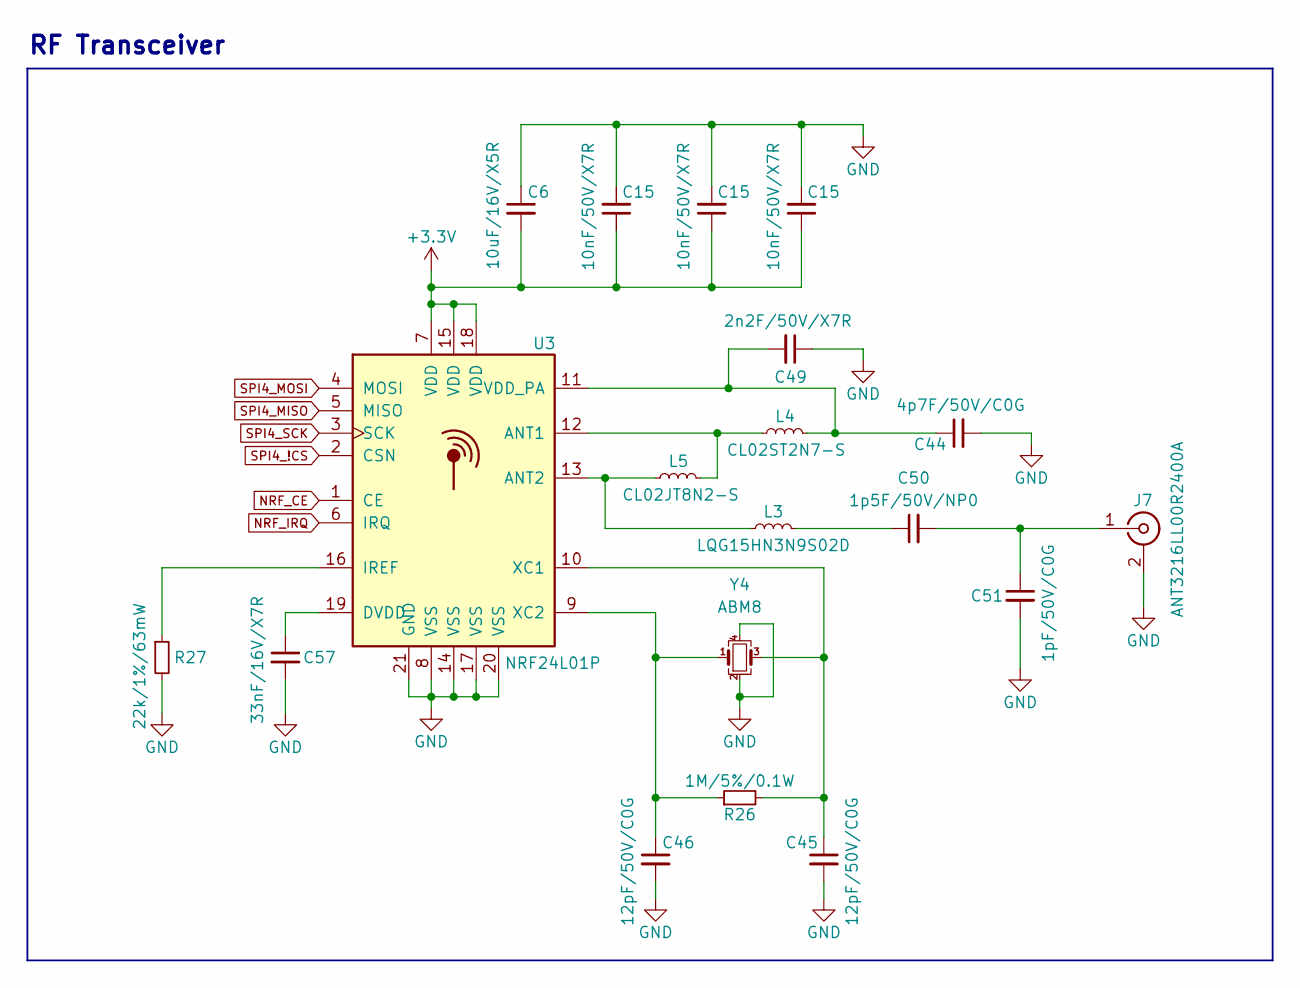
[picture p22: schematic Radio.kicad_sch]

Parts:
C6: 10uF/16V/X5R; C_0603_1608Metric
C15: 10nF/50V/X7R; C_0402_1005Metric
C44: 4p7F/50V/C0G; C_0402_1005Metric
C45, C46: 12pF/50V/C0G; C_0402_1005Metric
C49: 2n2F/50V/X7R; C_0402_1005Metric
C50: 1p5F/50V/NP0; C_0402_1005Metric
C51: 1pF/50V/C0G; C_0402_1005Metric
C57: 33nF/16V/X7R; C_0402_1005Metric
J7: ANT3216LL00R2400A; Johanson_2450AT18x100
L3: LQG15HN3N9S02D; L_0402_1005Metric
L4: CL02ST2N7-S; L_0402_1005Metric
L5: CL02JT8N2-S; L_0402_1005Metric
R26: 1M/5%/0.1W; R_0402_1005Metric
R27: 22k/1%/63mW; R_0402_1005Metric
U3: NRF24L01P; QFN-20-1EP_4x4mm_P0.5mm_EP2.5x2.5mm
Y4: ABM8; Crystal_SMD_Abracon_ABM8AIG-4Pin_3.2x2.5mm

Connections:
+3.3V: C6.2, C15.1, U3.7 (VDD), U3.15 (VDD), U3.18 (VDD)
GND: C6.1, C15.2, C44.2, C45.2, C46.2, C49.1, C51.2, C57.2, J7.2 (Ext), R27.2, U3.8 (VSS), U3.14 (VSS), U3.17 (VSS), U3.20 (VSS), U3.21 (GND), Y4.2, Y4.4
NRF_CE: U3.1 (CE)
NRF_IRQ: U3.6 (IRQ)
unnamed: C44.1, C49.2, L4.2, U3.11 (VDD_PA)
unnamed: C45.1, R26.2, U3.10 (XC1), Y4.3
unnamed: C46.1, R26.1, U3.9 (XC2), Y4.1
unnamed: C50.1, L3.2
unnamed: C50.2, C51.1, J7.1 (In)
unnamed: C57.1, U3.19 (DVDD)
unnamed: L3.1, L5.1, U3.13 (ANT2)
unnamed: L4.1, L5.2, U3.12 (ANT1)
unnamed: R27.1, U3.16 (IREF)
SPI4_!CS: U3.2 (CSN)
SPI4_MISO: U3.5 (MISO)
SPI4_MOSI: U3.4 (MOSI)
SPI4_SCK: U3.3 (SCK)

Notes on the sheet:
RF Transceiver
