Mimek32/Engineering-Thesis/Stepper Motors.kicad_sch

## KiCad design Stepper Motors.kicad_sch (2023-10-09)

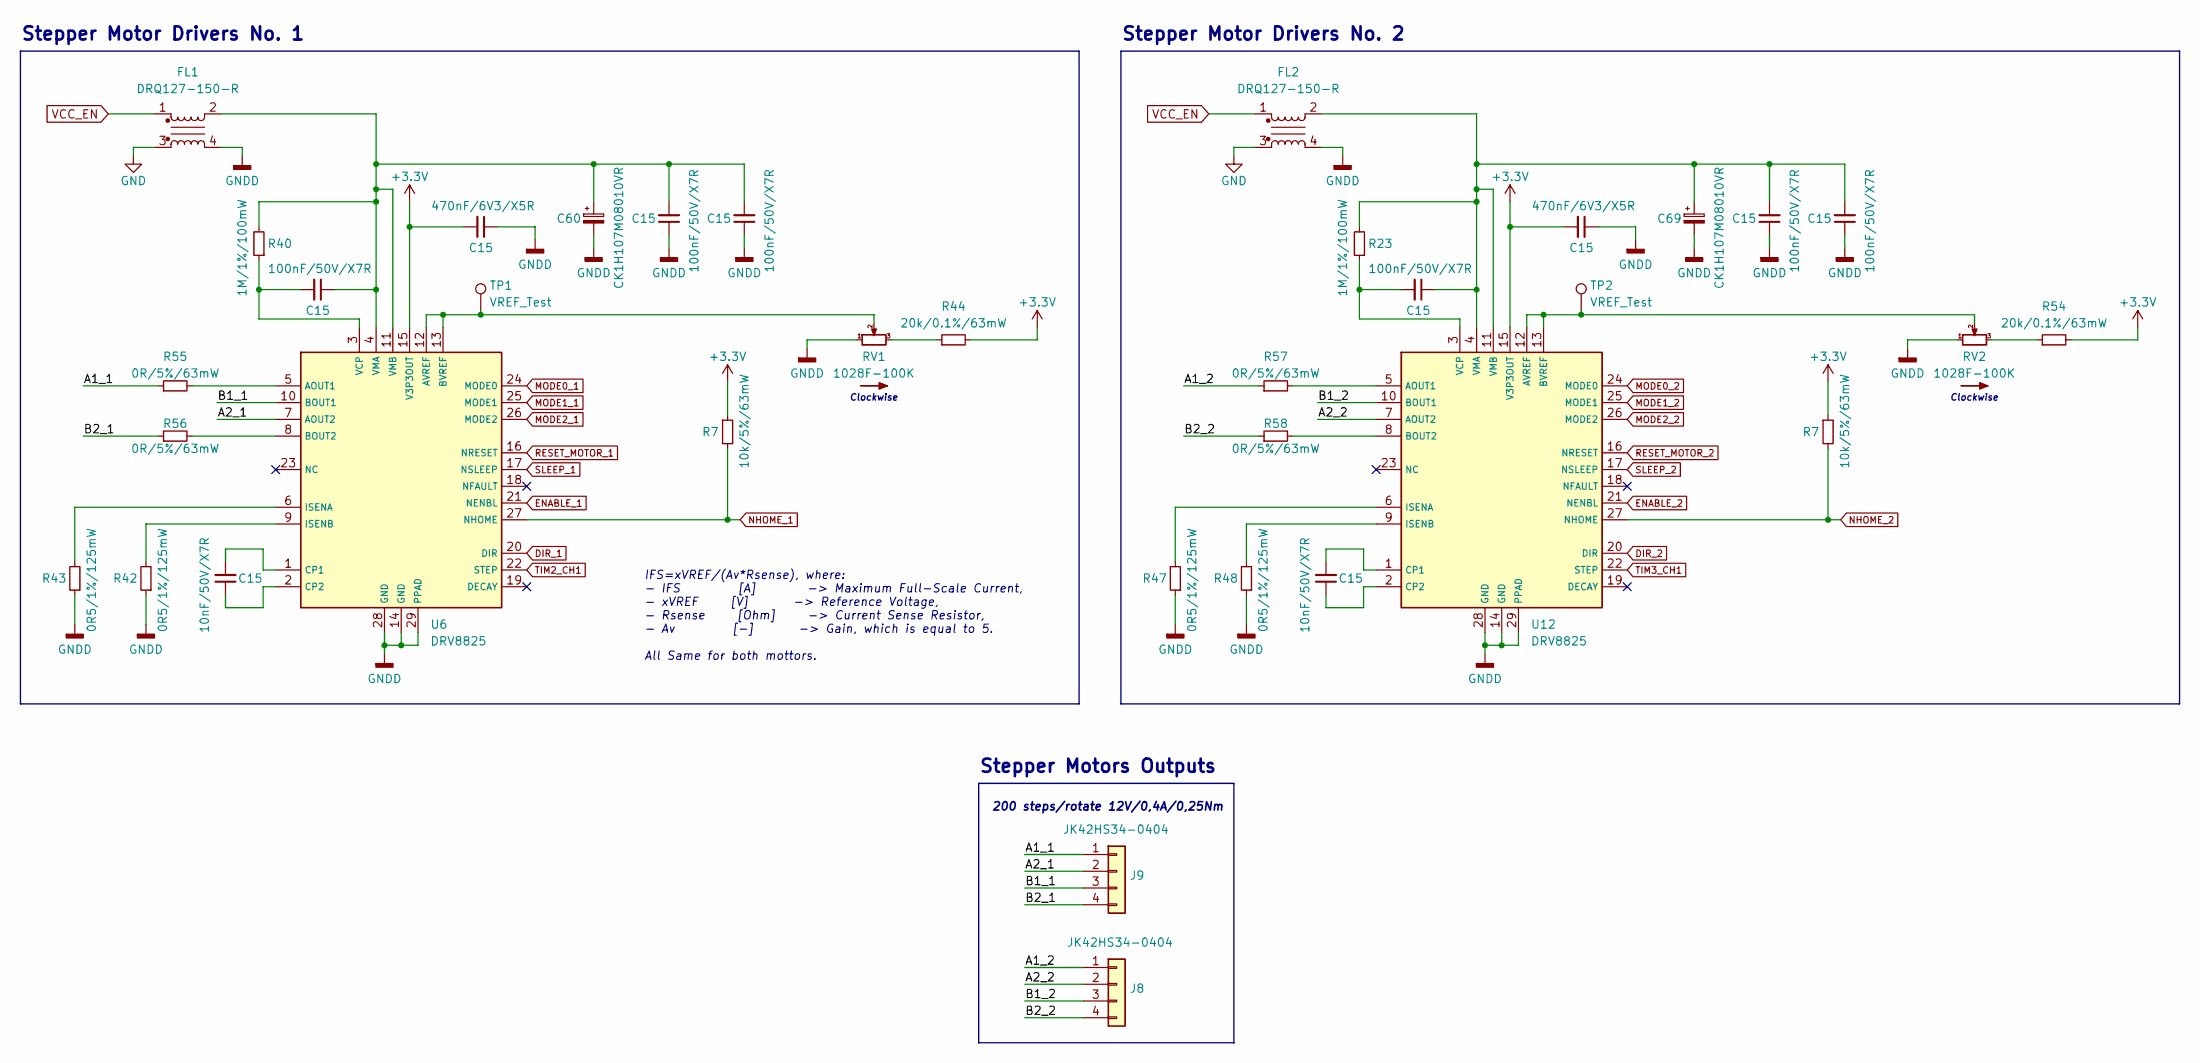
[picture p23: schematic Stepper Motors.kicad_sch]

Parts:
C15: 100nF/50V/X7R; C_0402_1005Metric
C60, C69: CK1H107M08010VR; CP_Elec_8x10
FL1, FL2: DRQ127-150-R; L_Bourns_SRF1260
J8, J9: JK42HS34-0404; SolderWire-0.1sqmm_1x04_P3.6mm_D0.4mm_OD1mm_Relief
R7: 10k/5%/63mW; R_0402_1005Metric
R23, R40: 1M/1%/100mW; R_0402_1005Metric
R42, R43, R47, R48: 0R5/1%/125mW; R_0402_1005Metric
R44, R54: 20k/0.1%/63mW; R_0402_1005Metric
R55, R56, R57, R58: 0R/5%/63mW; R_0402_1005Metric
RV1, RV2: 1028F-100K; Potentiometer_Bourns_3386F_Vertical
TP1, TP2: VREF_Test; TestPoint_Pad_D3.0mm
U6, U12: DRV8825; HTSSOP-28-1EP_4.4x9.7mm_P0.65mm_EP2.85x5.4mm

Connections:
+3.3V: C15.2, R7.1, R44.2, R54.2, U6.15 (V3P3OUT), U12.15 (V3P3OUT)
A1_1: J9.1, R55.1
A1_2: J8.1, R57.1
A2_1: J9.2, U6.7 (AOUT2)
A2_2: J8.2, U12.7 (AOUT2)
B1_1: J9.3, U6.10 (BOUT1)
B1_2: J8.3, U12.10 (BOUT1)
B2_1: J9.4, R56.1
B2_2: J8.4, R58.1
DIR_1: U6.20 (DIR)
DIR_2: U12.20 (DIR)
ENABLE_1: U6.21 (NENBL)
ENABLE_2: U12.21 (NENBL)
GND: FL1.3, FL2.3
GNDD: C15.1, C60.2, C69.2, FL1.4, FL2.4, R42.1, R43.1, R47.1, R48.1, RV1.1, RV2.1, U6.14 (GND), U6.28 (GND), U6.29 (PPAD), U12.14 (GND), U12.28 (GND), U12.29 (PPAD)
MODE0_1: U6.24 (MODE0)
MODE0_2: U12.24 (MODE0)
MODE1_1: U6.25 (MODE1)
MODE1_2: U12.25 (MODE1)
MODE2_1: U6.26 (MODE2)
MODE2_2: U12.26 (MODE2)
NHOME_1: R7.2, U6.27 (NHOME)
NHOME_2: R7.2, U12.27 (NHOME)
unnamed: C15.1, C15.2, C60.1, C69.1, FL1.2, FL2.2, R23.2, R40.2, U6.2 (CP2), U6.4 (VMA), U6.11 (VMB), U12.2 (CP2), U12.4 (VMA), U12.11 (VMB)
unnamed: C15.2, R23.1, R40.1, U6.1 (CP1), U6.3 (VCP), U12.1 (CP1), U12.3 (VCP)
unnamed: R42.2, U6.9 (ISENB)
unnamed: R43.2, U6.6 (ISENA)
unnamed: R44.1, RV1.3
unnamed: R47.2, U12.6 (ISENA)
unnamed: R48.2, U12.9 (ISENB)
unnamed: R54.1, RV2.3
unnamed: R55.2, U6.5 (AOUT1)
unnamed: R56.2, U6.8 (BOUT2)
unnamed: R57.2, U12.5 (AOUT1)
unnamed: R58.2, U12.8 (BOUT2)
unnamed: RV1.2, TP1.1, U6.12 (AVREF), U6.13 (BVREF)
unnamed: RV2.2, TP2.1, U12.12 (AVREF), U12.13 (BVREF)
RESET_MOTOR_1: U6.16 (NRESET)
RESET_MOTOR_2: U12.16 (NRESET)
SLEEP_1: U6.17 (NSLEEP)
SLEEP_2: U12.17 (NSLEEP)
TIM2_CH1: U6.22 (STEP)
TIM3_CH1: U12.22 (STEP)
VCC_EN: FL1.1, FL2.1

Notes on the sheet:
Stepper Motors Outputs
200 steps/rotate 12V/0,4A/0,25Nm
IFS=xVREF/(Av*Rsense), where: - IFS [A] -> Maximum Full-Scale Current, - xVREF [V] -> Reference Voltage, - Rsense [Ohm] -> Current Sense Resistor, - Av [-] -> Gain, which is equal to 5. All Same for both mottors.
Clockwise
Stepper Motor Drivers No. 2
Stepper Motor Drivers No. 1
