Mimek32/Engineering-Thesis/Touch Screen.kicad_sch

## KiCad design Touch Screen.kicad_sch (2023-10-09)

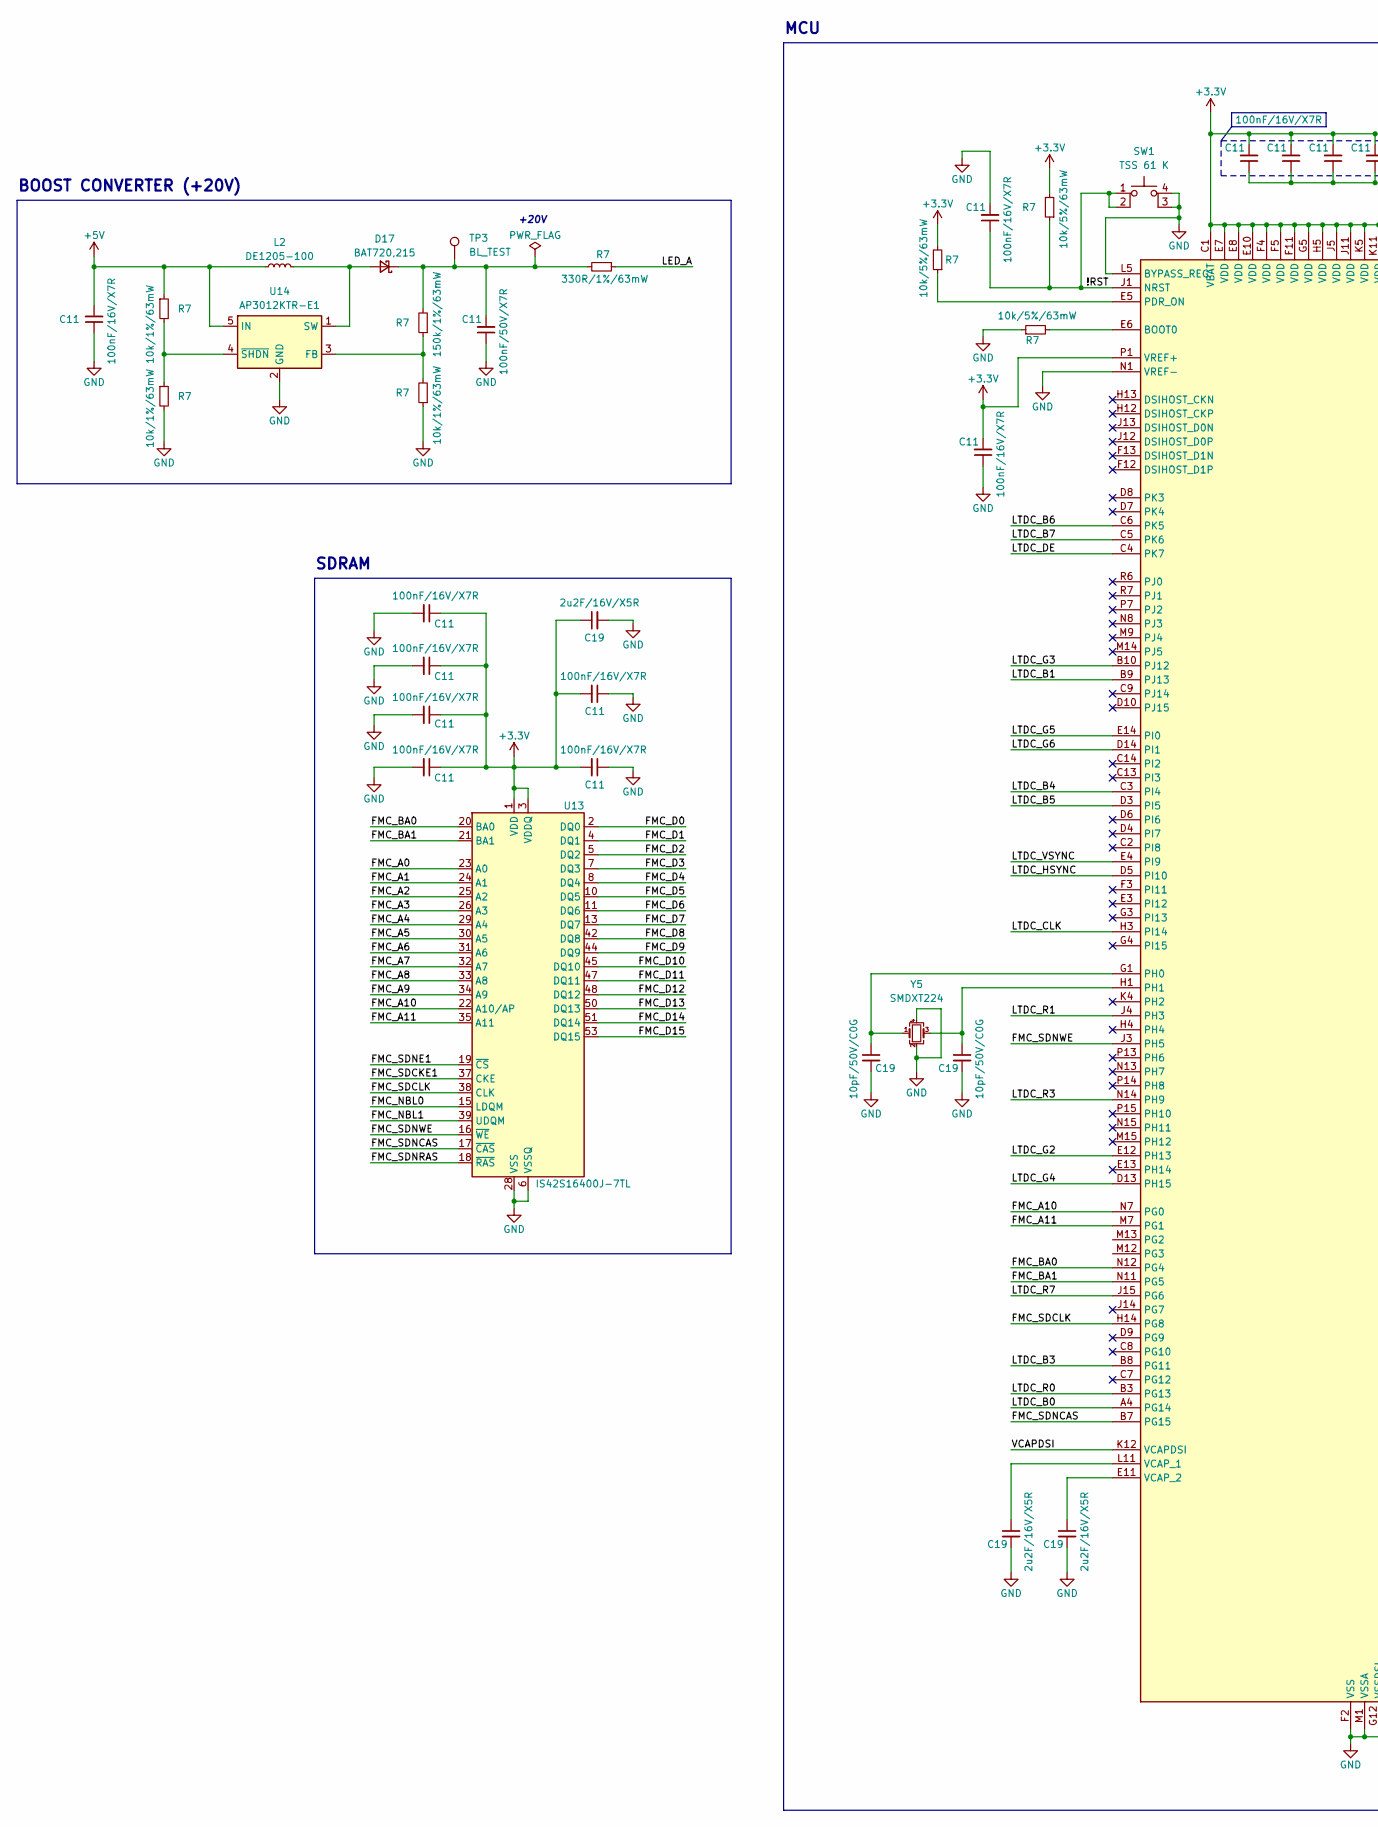
[picture p24: schematic Touch Screen.kicad_sch, part in row 1, column 1]

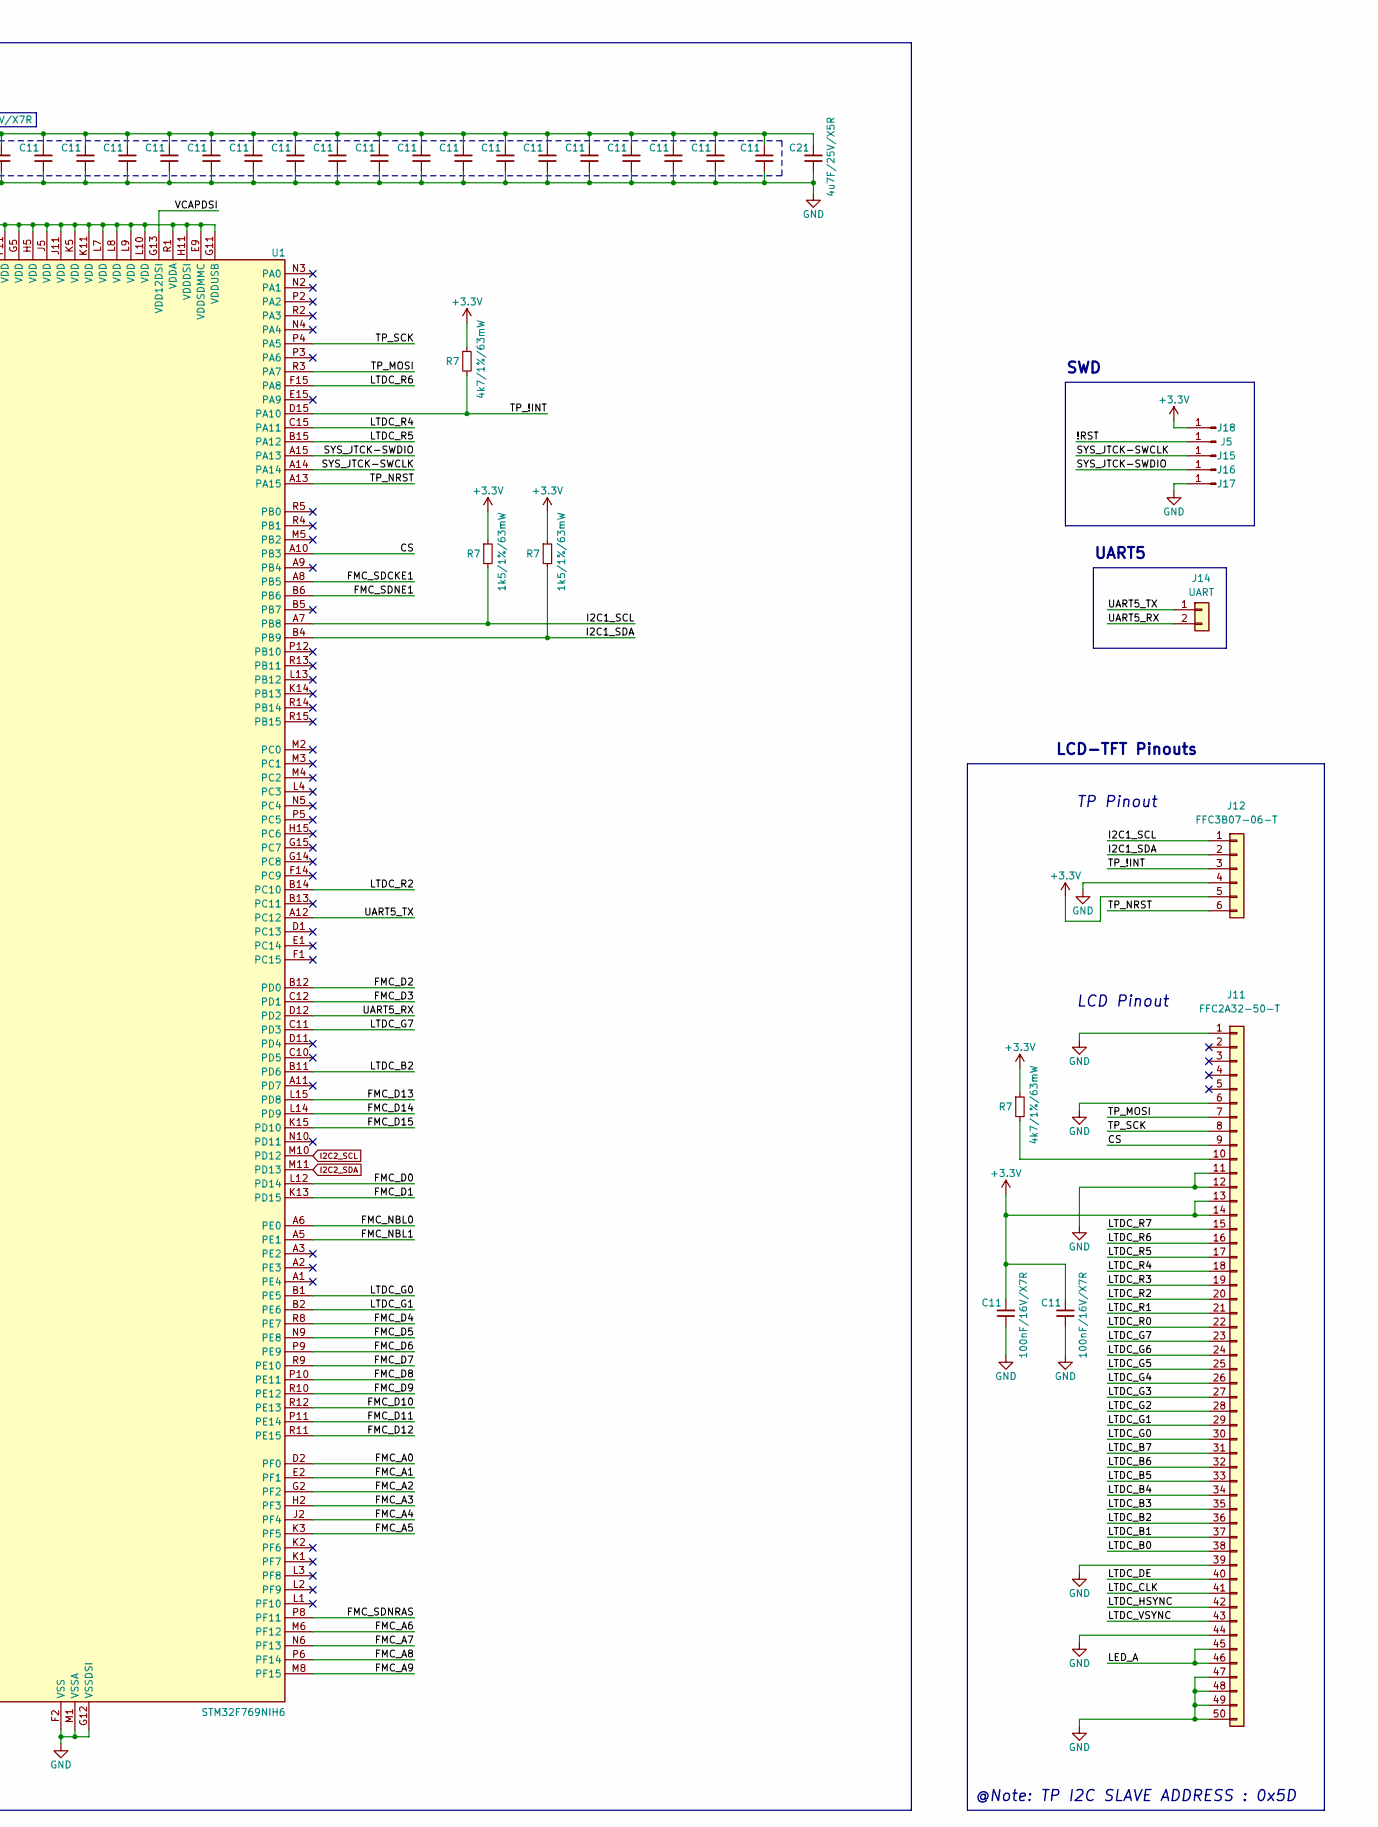
[picture p25: schematic Touch Screen.kicad_sch, part in row 1, column 2]

Parts:
C11: 100nF/16V/X7R; C_0402_1005Metric
C19: 2u2F/16V/X5R; C_0402_1005Metric
C21: 4u7F/25V/X5R; C_0603_1608Metric
D17: BAT720,215; TSOT-23
J5, J15, J16, J17, J18: Conn_01x01_Pin; TestPoint_Pad_4.0x4.0mm
J11: FFC2A32-50-T; Molex_54132-5033_1x50-1MP_P0.5mm_Horizontal
J12: FFC3B07-06-T; Molex_200528-0060_1x06-1MP_P1.00mm_Horizontal
J14: UART; PinHeader_1x02_P2.54mm_Vertical_SMD_Pin1Right
L2: DE1205-100; L_12x12mm_H6mm
R7: 1k5/1%/63mW; R_0402_1005Metric
SW1: TSS 61 K; SW_Push_1P1T_NO_6x6mm_H9.5mm
TP3: BL_TEST; TestPoint_Pad_D3.0mm
U1: STM32F769NIH6; TFBGA-216_13x13mm_Layout15x15_P0.8mm
U13: IS42S16400J-7TL; TSOP-II-54_22.2x10.16mm_P0.8mm
U14: AP3012KTR-E1; SOT-23-5
Y5: SMDXT224; Crystal_SMD_2520-4Pin_2.5x2.0mm

Connections:
!RST: C11.1, J5.1, R7.1, SW1.1, SW1.2, U1.J1 (NRST)
+3.3V: C11.1, C11.2, C19.1, C21.2, J11.13, J11.14, J12.5, J18.1, R7.1, R7.2, U1.C1 (VBAT), U1.E7 (VDD), U1.E8 (VDD), U1.E9 (VDDSDMMC), U1.E10 (VDD), U1.F4 (VDD), U1.F5 (VDD), U1.F11 (VDD), U1.G5 (VDD), U1.G11 (VDDUSB), U1.H5 (VDD), U1.H11 (VDDDSI), U1.J5 (VDD), U1.J11 (VDD), U1.K5 (VDD), U1.K11 (VDD), U1.L7 (VDD), U1.L8 (VDD), U1.L9 (VDD), U1.L10 (VDD), U1.P1 (VREF+), U1.R1 (VDDA), U13.1 (VDD), U13.3 (VDDQ), U13.9 (VDDQ), U13.14 (VDD), U13.27 (VDD), U13.43 (VDDQ), U13.49 (VDDQ)
+5V: C11.2, L2.1, R7.1, U14.5 (IN)
CS: J11.9, U1.A10 (PB3)
FMC_A0: U1.D2 (PF0), U13.23 (A0)
FMC_A1: U1.E2 (PF1), U13.24 (A1)
FMC_A2: U1.G2 (PF2), U13.25 (A2)
FMC_A3: U1.H2 (PF3), U13.26 (A3)
FMC_A4: U1.J2 (PF4), U13.29 (A4)
FMC_A5: U1.K3 (PF5), U13.30 (A5)
FMC_A6: U1.M6 (PF12), U13.31 (A6)
FMC_A7: U1.N6 (PF13), U13.32 (A7)
FMC_A8: U1.P6 (PF14), U13.33 (A8)
FMC_A9: U1.M8 (PF15), U13.34 (A9)
FMC_A10: U1.N7 (PG0), U13.22 (A10/AP)
FMC_A11: U1.M7 (PG1), U13.35 (A11)
FMC_BA0: U1.N12 (PG4), U13.20 (BA0)
FMC_BA1: U1.N11 (PG5), U13.21 (BA1)
FMC_D0: U1.L12 (PD14), U13.2 (DQ0)
FMC_D1: U1.K13 (PD15), U13.4 (DQ1)
FMC_D2: U1.B12 (PD0), U13.5 (DQ2)
FMC_D3: U1.C12 (PD1), U13.7 (DQ3)
FMC_D4: U1.R8 (PE7), U13.8 (DQ4)
FMC_D5: U1.N9 (PE8), U13.10 (DQ5)
FMC_D6: U1.P9 (PE9), U13.11 (DQ6)
FMC_D7: U1.R9 (PE10), U13.13 (DQ7)
FMC_D8: U1.P10 (PE11), U13.42 (DQ8)
FMC_D9: U1.R10 (PE12), U13.44 (DQ9)
FMC_D10: U1.R12 (PE13), U13.45 (DQ10)
FMC_D11: U1.P11 (PE14), U13.47 (DQ11)
FMC_D12: U1.R11 (PE15), U13.48 (DQ12)
FMC_D13: U1.L15 (PD8), U13.50 (DQ13)
FMC_D14: U1.L14 (PD9), U13.51 (DQ14)
FMC_D15: U1.K15 (PD10), U13.53 (DQ15)
FMC_NBL0: U1.A6 (PE0), U13.15 (LDQM)
FMC_NBL1: U1.A5 (PE1), U13.39 (UDQM)
FMC_SDCKE1: U1.A8 (PB5), U13.37 (CKE)
FMC_SDCLK: U1.H14 (PG8), U13.38 (CLK)
FMC_SDNCAS: U1.B7 (PG15), U13.17 (~CAS)
FMC_SDNE1: U1.B6, U13.19 (~CS)
FMC_SDNRAS: U1.P8 (PF11), U13.18 (~RAS)
FMC_SDNWE: U1.J3 (PH5), U13.16 (~WE)
GND: C11.1, C11.2, C19.2, C21.1, J11.1, J11.6, J11.11, J11.12, J11.39, J11.44 (Pin_40), J11.47 (Pin_40), J11.48 (Pin_40), J11.49 (Pin_40), J11.50 (Pin_40), J12.4, J17.1, R7.1, R7.2, SW1.3 (K), SW1.4 (A), U1.F2 (VSS), U1.F6 (VSS), U1.F7 (VSS), U1.F8 (VSS), U1.F9 (VSS), U1.F10 (VSS), U1.G6 (VSS), U1.G10 (VSS), U1.G12 (VSSDSI), U1.H6 (VSS), U1.H10 (VSS), U1.J6 (VSS), U1.J10 (VSS), U1.K6 (VSS), U1.K7 (VSS), U1.K8 (VSS), U1.K9 (VSS), U1.K10 (VSS), U1.L5 (BYPASS_REG), U1.L6 (VSS), U1.M1 (VSSA), U1.N1 (VREF-), U13.6 (VSSQ), U13.12 (VSSQ), U13.28 (VSS), U13.41 (VSS), U13.46 (VSSQ), U13.52 (VSSQ), U13.54 (VSS), U14.2 (GND), Y5.2, Y5.4
I2C1_SCL: J12.1, R7.2, U1.A7 (PB8)
I2C1_SDA: J12.2, R7.2, U1.B4 (PB9)
I2C2_SCL: U1.M10 (PD12)
I2C2_SDA: U1.M11 (PD13)
LED_A: J11.45 (Pin_40), J11.46 (Pin_40), R7.1
LTDC_B0: J11.38, U1.A4 (PG14)
LTDC_B1: J11.37, U1.B9 (PJ13)
LTDC_B2: J11.36, U1.B11 (PD6)
LTDC_B3: J11.35, U1.B8 (PG11)
LTDC_B4: J11.34, U1.C3 (PI4)
LTDC_B5: J11.33, U1.D3 (PI5)
LTDC_B6: J11.32, U1.C6 (PK5)
LTDC_B7: J11.31, U1.C5 (PK6)
LTDC_CLK: J11.41 (Pin_40), U1.H3 (PI14)
LTDC_DE: J11.40, U1.C4 (PK7)
LTDC_G0: J11.30, U1.B1 (PE5)
LTDC_G1: J11.29, U1.B2 (PE6)
LTDC_G2: J11.28, U1.E12 (PH13)
LTDC_G3: J11.27, U1.B10 (PJ12)
LTDC_G4: J11.26, U1.D13 (PH15)
LTDC_G5: J11.25, U1.E14 (PI0)
LTDC_G6: J11.24, U1.D14 (PI1)
LTDC_G7: J11.23, U1.C11 (PD3)
LTDC_HSYNC: J11.42 (Pin_40), U1.D5 (PI10)
LTDC_R0: J11.22, U1.B3 (PG13)
LTDC_R1: J11.21, U1.J4 (PH3)
LTDC_R2: J11.20, U1.B14 (PC10)
LTDC_R3: J11.19, U1.N14 (PH9)
LTDC_R4: J11.18, U1.C15 (PA11)
LTDC_R5: J11.17, U1.B15 (PA12)
LTDC_R6: J11.16, U1.F15 (PA8)
LTDC_R7: J11.15, U1.J15 (PG6)
LTDC_VSYNC: J11.43 (Pin_40), U1.E4 (PI9)
unnamed: C11.2, D17.1 (K), R7.2, TP3.1
unnamed: C19.1, U1.E11 (VCAP_2), U1.G1 (PH0), U1.H1, U1.L11 (VCAP_1), Y5.1, Y5.3
unnamed: D17.2 (A), L2.2, U14.1 (SW)
unnamed: J11.10, R7.2
unnamed: R7.1, R7.2, U1.E5 (PDR_ON), U14.3 (FB), U14.4 (~SHDN)
unnamed: R7.2, U1.E6 (BOOT0)
SYS_JTCK-SWCLK: J15.1, U1.A14
SYS_JTCK-SWDIO: J16.1, U1.A15 (PA13)
TP_!INT: J12.3, R7.2, U1.D15 (PA10)
TP_MOSI: J11.7, U1.R3 (PA7)
TP_NRST: J12.6, U1.A13 (PA15)
TP_SCK: J11.8, U1.P4 (PA5)
UART5_RX: J14.2, U1.D12 (PD2)
UART5_TX: J14.1, U1.A12 (PC12)
VCAPDSI: U1.G13 (VDD12DSI), U1.K12 (VCAPDSI)

Notes on the sheet:
LCD-TFT Pinouts
MCU
@Note: TP I2C SLAVE ADDRESS : 0x5D
LCD Pinout
BOOST CONVERTER (+20V)
SDRAM
UART5
TP Pinout
+20V
SWD
